gokberkgucin/MIT_Buck_Converter_Design_TAMAMLANDI/docs/assets/full-report/manifest.md

# Full Report Asset Manifest

Bu manifest, kaynak DOCX içindeki görselleri ve denklem görseli gibi teknik medya varlıklarını semantik dosya adlarıyla izler.

## Özet

- Kaynak DOCX: `Birinci_donem_Buck_Converter_Serbest_Projesi.docx`
- Asset kökü: `docs/assets/full-report`
- Toplam medya varlığı: 53
- Mevcut repo görselinden yeniden kullanılan: 53
- Denklem/ifade görseli olarak tutulan: 14
- Decorative/küçük nesne olarak işaretlenen: 5
- Kaynak Word native denklem nesnesi: 151
- Kaynak Word native denklem paragrafı: 65

Not: Native OMML denklem nesneleri bu asset çıkarıcısında tahminle kırpılmadı. DOCX içinde bitmap olarak bulunan denklem/ifade görselleri `media_type=equation-image` olarak kataloglandı.

## Asset Tablosu

| filename | source_location | probable_section | nearby_text_or_caption | media_type | reused_existing_asset |
| --- | --- | --- | --- | --- | --- |
| `docs/assets/full-report/power-stage/image01-type-3-compensator-frequency-relations.png` | word/media/image1.png; relationship=rId17; image_kind=drawingml; document_order=1; source_heading=Frekans Seçim Kuralları ve Hesaplamalar | Bölüm 2.1 | Type-3 compensator frekans ilişkileri | equation-image | true |
| `docs/assets/full-report/power-stage/image02-frequency-ordering.png` | word/media/image2.png; relationship=rId18; image_kind=drawingml; document_order=2; source_heading=Frekans Seçim Kuralları ve Hesaplamalar | Bölüm 2.1 | Frekans sıralaması | technical-figure | true |
| `docs/assets/full-report/power-stage/image03-updated-power-stage-calculation-flow.png` | word/media/image3.png; relationship=rId19; image_kind=drawingml; document_order=3; source_heading=Güç Katı Hesaplamaları: | Bölüm 3.2 | Güç katı hesap akışı/devre görseli | technical-figure | true |
| `docs/assets/full-report/power-stage/image04-duty-cycle-36v-ltspice-check.jpeg` | word/media/image4.jpeg; relationship=rId20; image_kind=drawingml; document_order=4; source_heading=Güç Katı Hesaplamaları: | Bölüm 3.3 | 36 V duty-cycle kontrolü | simulation-screenshot | true |
| `docs/assets/full-report/power-stage/image05-duty-cycle-24v-ltspice-check.png` | word/media/image5.png; relationship=rId21; image_kind=drawingml; document_order=5; source_heading=Güç Katı Hesaplamaları: | Bölüm 3.3 | 24 V duty-cycle kontrolü | simulation-screenshot | true |
| `docs/assets/full-report/state-equations/image06-buck-converter-state-equations.png` | word/media/image6.png; relationship=rId22; image_kind=drawingml; document_order=6; source_heading=Çevirici Durum Denklemleri | Bölüm 4 | Durum denklemleri | equation-image | true |
| `docs/assets/full-report/state-equations/image07-esr-effect-output-voltage.png` | word/media/image7.png; relationship=rId23; image_kind=drawingml; document_order=7; source_heading=ESR Etkisi | Bölüm 4.1 | ESR etkisi | technical-figure | true |
| `docs/assets/full-report/state-equations/image08-current-voltage-general-waveforms.png` | word/media/image8.png; relationship=rId24; image_kind=drawingml; document_order=8; source_heading=ESR Etkisi | Bölüm 4.1 | Genel akım/gerilim dalga biçimleri | waveform-diagram | true |
| `docs/assets/full-report/state-equations/image09-waveform-label-small-signal.png` | word/media/image9.png; relationship=rId25; image_kind=drawingml; document_order=9; source_heading=Genel Dalga-Biçimleri | Bölüm 4.2 | Dalga biçimi etiket görseli | equation-image | true |
| `docs/assets/full-report/state-equations/image10-waveform-equation-label.png` | word/media/image10.png; relationship=rId26; image_kind=drawingml; document_order=10; source_heading=Genel Dalga-Biçimleri | Bölüm 4.2 | Dalga biçimi denklem/etiket görseli | equation-image | true |
| `docs/assets/full-report/state-equations/image11-buck-converter-general-waveforms.png` | word/media/image11.png; relationship=rId27; image_kind=drawingml; document_order=11; source_heading=Genel Dalga-Biçimleri | Bölüm 4.2 | Buck converter genel dalga biçimleri | waveform-diagram | true |
| `docs/assets/full-report/state-equations/image12-decorative-small-media-12.png` | word/media/image12.png; relationship=rId29; image_kind=vml; document_order=14; source_heading=Genel Dalga-Biçimleri | Bölüm 4.2 | Kaynak DOCX küçük medya nesnesi; eksiksiz aktarım için ölçeklenerek bağlandı | decorative | true |
| `docs/assets/full-report/state-equations/image13-decorative-small-media-13.png` | word/media/image13.png; relationship=rId31; image_kind=vml; document_order=13; source_heading=Genel Dalga-Biçimleri | Bölüm 4.2 | Kaynak DOCX küçük medya nesnesi; eksiksiz aktarım için ölçeklenerek bağlandı | decorative | true |
| `docs/assets/full-report/controller/image14-controller-design-transition-diagram.png` | word/media/image14.png; relationship=rId33; image_kind=drawingml; document_order=15; source_heading=kontrolcu tasarımı | Bölüm 5 | Kontrolcü tasarımı giriş diyagramı | block-diagram | true |
| `docs/assets/full-report/controller/image15-system-block-diagram.png` | word/media/image15.png; relationship=rId34; image_kind=drawingml; document_order=16; source_heading=kontrolcu tasarımı | Bölüm 5.1 | Sistem block diagramı | block-diagram | true |
| `docs/assets/full-report/controller/image16-closed-loop-expression-1.png` | word/media/image16.png; relationship=rId35; image_kind=drawingml; document_order=17; source_heading=kontrolcu tasarımı | Bölüm 5.1 | Kapalı çevrim ifade ilişkisi | equation-image | true |
| `docs/assets/full-report/controller/image17-closed-loop-expression-2.png` | word/media/image17.png; relationship=rId36; image_kind=drawingml; document_order=18; source_heading=kontrolcu tasarımı | Bölüm 5.1 | Kapalı çevrim ifade ilişkisi | equation-image | true |
| `docs/assets/full-report/controller/image18-open-loop-transfer-function-block-expression.png` | word/media/image18.png; relationship=rId37; image_kind=drawingml; document_order=19; source_heading=Kontrolcu Hesabı | Bölüm 5.3 | Açık çevrim transfer fonksiyonu | equation-image | true |
| `docs/assets/full-report/controller/image19-uncompensated-loop-gain-expression.png` | word/media/image19.png; relationship=rId38; image_kind=drawingml; document_order=20; source_heading=Kontrolcu Hesabı | Bölüm 5.3 | Uncompensated loop gain ifadesi | equation-image | true |
| `docs/assets/full-report/controller/image20-uncompensated-loop-gain-bode.png` | word/media/image20.png; relationship=rId39; image_kind=drawingml; document_order=21; source_heading=Kontrolcu Hesabı | Bölüm 5.3 | Uncompensated Bode diyagramı | bode-plot | true |
| `docs/assets/full-report/controller/image21-lead-compensator-bode-shape.png` | word/media/image21.png; relationship=rId40; image_kind=drawingml; document_order=22; source_heading=Kontrolcu Hesabı | Bölüm 5.4 | Lead compensator Bode davranışı | bode-plot | true |
| `docs/assets/full-report/controller/image22-lead-compensator-frequency-response.png` | word/media/image22.png; relationship=rId41; image_kind=drawingml; document_order=23; source_heading=Kontrolcu Hesabı | Bölüm 5.4 | Lead compensator frekans cevabı | bode-plot | true |
| `docs/assets/full-report/controller/image23-lead-compensated-open-loop-bode.png` | word/media/image23.png; relationship=rId42; image_kind=drawingml; document_order=24; source_heading=Kontrolcu Hesabı | Bölüm 5.4 | Lead sonrası açık çevrim Bode | bode-plot | true |
| `docs/assets/full-report/controller/image24-lag-pi-compensator-bode-shape.png` | word/media/image24.png; relationship=rId43; image_kind=drawingml; document_order=25; source_heading=Kontrolcu Hesabı | Bölüm 5.5 | Lag/PI compensator Bode davranışı | bode-plot | true |
| `docs/assets/full-report/controller/image25-pid-compensator-bode-curve.png` | word/media/image25.png; relationship=rId44; image_kind=drawingml; document_order=26; source_heading=Kontrolcu Hesabı | Bölüm 5.6 | PID compensator Bode eğrisi | bode-plot | true |
| `docs/assets/full-report/controller/image26-lt1215-opamp-gain-frequency.png` | word/media/image26.png; relationship=rId45; image_kind=drawingml; document_order=27; source_heading=Kontrolcu Hesabı | Bölüm 5.7 | LT1215 op-amp gain/frequency grafiği | technical-figure | true |
| `docs/assets/full-report/controller/image27-final-open-loop-bode.png` | word/media/image27.png; relationship=rId46; image_kind=drawingml; document_order=28; source_heading=Kontrolcu Hesabı | Bölüm 5.8 | Nihai açık çevrim Bode | bode-plot | true |
| `docs/assets/full-report/controller/image28-calculated-open-loop-transfer-function.png` | word/media/image28.png; relationship=rId47; image_kind=drawingml; document_order=29; source_heading=Kontrolcu Hesabı | Bölüm 5.8 | Hesaplanan $T(s)$ | equation-image | true |
| `docs/assets/full-report/controller/image29-t-of-s-closed-loop-expressions.png` | word/media/image29.png; relationship=rId48; image_kind=drawingml; document_order=30; source_heading=Kontrolcu Hesabı | Bölüm 5.8 | $T(s)$ kapalı çevrim ifadeleri | equation-image | true |
| `docs/assets/full-report/controller/image30-decorative-small-media-30.png` | word/media/image30.png; relationship=rId50; image_kind=vml; document_order=32; source_heading=Kontrolcu Hesabı | Bölüm 5.8 | Kaynak DOCX küçük medya nesnesi; eksiksiz aktarım için ölçeklenerek bağlandı | decorative | true |
| `docs/assets/full-report/controller/image31-closed-loop-reference-to-output-response.png` | word/media/image31.png; relationship=rId51; image_kind=drawingml; document_order=31; source_heading=Kontrolcu Hesabı | Bölüm 5.8 | Reference-to-output cevabı | bode-plot | true |
| `docs/assets/full-report/opamp/image32-decorative-small-media-32.png` | word/media/image32.png; relationship=rId53; image_kind=vml; document_order=33; source_heading=Op-amp devresi -gerçeklemesi | Bölüm 6 | Kaynak DOCX küçük medya nesnesi; eksiksiz aktarım için ölçeklenerek bağlandı | decorative | true |
| `docs/assets/full-report/opamp/image33-decorative-small-media-33.png` | word/media/image33.png; relationship=rId55; image_kind=vml; document_order=34; source_heading=Op-amp devresi -gerçeklemesi | Bölüm 6 | Kaynak DOCX küçük medya nesnesi; eksiksiz aktarım için ölçeklenerek bağlandı | decorative | true |
| `docs/assets/full-report/opamp/image34-opamp-implementation-circuit.png` | word/media/image34.png; relationship=rId56; image_kind=drawingml; document_order=35; source_heading=Op-amp devresi -gerçeklemesi | Bölüm 6 | Op-amp gerçekleştirme devresi | circuit-diagram | true |
| `docs/assets/full-report/opamp/image35-sensor-gain-voltage-divider.png` | word/media/image35.png; relationship=rId57; image_kind=drawingml; document_order=36; source_heading=Sensor Gain (H(s)) | Bölüm 6.1 | Sensor gain gerilim bölücü | circuit-diagram | true |
| `docs/assets/full-report/opamp/image36-compensator-target-frequency-gain.png` | word/media/image36.png; relationship=rId58; image_kind=drawingml; document_order=37; source_heading=Compensator Devresi | Bölüm 6.2 | Compensator hedef frekans/kazanç davranışı | technical-figure | true |
| `docs/assets/full-report/opamp/image37-simplified-compensator-circuit.png` | word/media/image37.png; relationship=rId59; image_kind=drawingml; document_order=38; source_heading=Compensator Devresi | Bölüm 6.2 | Sadeleştirilmiş compensator devresi | circuit-diagram | true |
| `docs/assets/full-report/opamp/image38-r2-c2-impedance-comparison.png` | word/media/image38.png; relationship=rId60; image_kind=drawingml; document_order=42; source_heading=Compensator Devresi | Bölüm 6.2 | $R_2$ ve $C_2$ empedans davranışı | equation-image | true |
| `docs/assets/full-report/opamp/image39-capacitor-impedance-plus-20db-dec.png` | word/media/image39.png; relationship=rId61; image_kind=drawingml; document_order=40; source_heading=Compensator Devresi | Bölüm 6.2 | $+20\,\text{dB/dec}$ eğim | equation-image | true |
| `docs/assets/full-report/opamp/image40-z1-z2-impedance-network-1.png` | word/media/image40.png; relationship=rId62; image_kind=drawingml; document_order=41; source_heading=Compensator Devresi | Bölüm 6.2 | $Z_1/Z_2$ empedans ağı | equation-image | true |
| `docs/assets/full-report/opamp/image41-z1-z2-impedance-network-2.png` | word/media/image41.png; relationship=rId63; image_kind=drawingml; document_order=43; source_heading=Compensator Devresi | Bölüm 6.2 | $Z_1/Z_2$ empedans ağı | equation-image | true |
| `docs/assets/full-report/simulation/image42-output-power-50w-operating-point.png` | word/media/image42.png; relationship=rId64; image_kind=drawingml; document_order=44; source_heading=Çıkış Gücü | Bölüm 7.3 | Yaklaşık 49.6 W çıkış gücü | simulation-screenshot | true |
| `docs/assets/full-report/simulation/image43-output-power-125w-operating-point.png` | word/media/image43.png; relationship=rId65; image_kind=drawingml; document_order=45; source_heading=Çıkış Gücü | Bölüm 7.3 | Yaklaşık 124.2 W çıkış gücü | simulation-screenshot | true |
| `docs/assets/full-report/simulation/image44-static-output-voltage-measurement.png` | word/media/image44.png; relationship=rId66; image_kind=drawingml; document_order=46; source_heading=Output Voltage (static requirement): | Bölüm 7.4 | Statik çıkış gerilimi | simulation-screenshot | true |
| `docs/assets/full-report/simulation/image45-transient-output-voltage-load-current.png` | word/media/image45.png; relationship=rId67; image_kind=drawingml; document_order=47; source_heading=Output Voltage (transient limits): | Bölüm 7.5 | Transient çıkış gerilimi | simulation-screenshot | true |
| `docs/assets/full-report/simulation/image46-output-ripple-measurement.png` | word/media/image46.png; relationship=rId68; image_kind=drawingml; document_order=48; source_heading=Output Voltage (transient limits): | Bölüm 7.6 | Output ripple | simulation-screenshot | true |
| `docs/assets/full-report/simulation/image47-input-power-36v-measurement.png` | word/media/image47.png; relationship=rId69; image_kind=drawingml; document_order=49; source_heading=Allowed output voltage ripple (p-p, any R load) | Bölüm 7.7 | 36 V girişte giriş gücü | simulation-screenshot | true |
| `docs/assets/full-report/simulation/image48-output-power-36v-measurement.png` | word/media/image48.png; relationship=rId70; image_kind=drawingml; document_order=50; source_heading=Allowed output voltage ripple (p-p, any R load) | Bölüm 7.7 | 36 V girişte çıkış gücü | simulation-screenshot | true |
| `docs/assets/full-report/simulation/image49-output-power-24v-measurement.png` | word/media/image49.png; relationship=rId71; image_kind=drawingml; document_order=51; source_heading=Allowed output voltage ripple (p-p, any R load) | Bölüm 7.7 | 24 V girişte çıkış gücü | simulation-screenshot | true |
| `docs/assets/full-report/simulation/image50-input-power-24v-measurement.png` | word/media/image50.png; relationship=rId72; image_kind=drawingml; document_order=52; source_heading=Allowed output voltage ripple (p-p, any R load) | Bölüm 7.7 | 24 V girişte giriş gücü | simulation-screenshot | true |
| `docs/assets/full-report/future-work/image51-lm5146-typical-application.png` | word/media/image51.png; relationship=rId73; image_kind=drawingml; document_order=53; source_heading=PROJENIN GELECEĞİ | Bölüm 8 | LM5146 tipik uygulama | circuit-diagram | true |
| `docs/assets/full-report/appendices/image52-output-capacitor-datasheet-excerpt.png` | word/media/image52.png; relationship=rId74; image_kind=drawingml; document_order=54; source_heading=EK-2. Genel görünüm | Ek-1 | Sığaç veri sayfası | datasheet-excerpt | true |
| `docs/assets/full-report/appendices/image53-ltspice-circuit-overview.png` | word/media/image53.png; relationship=rId75; image_kind=drawingml; document_order=55; source_heading=EK-2. Genel görünüm | Ek-2 | LTspice devre genel görünümü | circuit-diagram | true |

## Yeniden Kullanılan Mevcut Görseller

| semantic_filename | source_asset | link_method | matching_existing_assets |
| --- | --- | --- | --- |
| `docs/assets/full-report/power-stage/image01-type-3-compensator-frequency-relations.png` | `docs/assets/docx-media/media/image1.png` | hardlink-existing | `docs/assets/docx-media/media/image1.png`, `docs/assets/docx-media/raw/image1.png`, `images/readme/type3_frequency_relations.png`, `images/docx_extracted/image1.png` |
| `docs/assets/full-report/power-stage/image02-frequency-ordering.png` | `docs/assets/docx-media/media/image2.png` | hardlink-existing | `docs/assets/docx-media/media/image2.png`, `docs/assets/docx-media/raw/image2.png`, `images/readme/frequency_ordering.png`, `images/docx_extracted/image2.png` |
| `docs/assets/full-report/power-stage/image03-updated-power-stage-calculation-flow.png` | `docs/assets/docx-media/media/image3.png` | hardlink-existing | `docs/assets/docx-media/media/image3.png`, `docs/assets/docx-media/raw/image3.png` |
| `docs/assets/full-report/power-stage/image04-duty-cycle-36v-ltspice-check.jpeg` | `docs/assets/docx-media/media/image4.jpeg` | hardlink-existing | `docs/assets/docx-media/media/image4.jpeg`, `docs/assets/docx-media/raw/image4.jpeg` |
| `docs/assets/full-report/power-stage/image05-duty-cycle-24v-ltspice-check.png` | `docs/assets/docx-media/media/image5.png` | hardlink-existing | `docs/assets/docx-media/media/image5.png`, `docs/assets/docx-media/raw/image5.png` |
| `docs/assets/full-report/state-equations/image06-buck-converter-state-equations.png` | `docs/assets/docx-media/media/image6.png` | hardlink-existing | `docs/assets/docx-media/media/image6.png`, `docs/assets/docx-media/raw/image6.png`, `images/readme/converter_state_equations.png`, `images/docx_extracted/image6.png` |
| `docs/assets/full-report/state-equations/image07-esr-effect-output-voltage.png` | `docs/assets/docx-media/media/image7.png` | hardlink-existing | `docs/assets/docx-media/media/image7.png`, `docs/assets/docx-media/raw/image7.png` |
| `docs/assets/full-report/state-equations/image08-current-voltage-general-waveforms.png` | `docs/assets/docx-media/media/image8.png` | hardlink-existing | `docs/assets/docx-media/media/image8.png`, `docs/assets/docx-media/raw/image8.png` |
| `docs/assets/full-report/state-equations/image09-waveform-label-small-signal.png` | `docs/assets/docx-media/media/image9.png` | hardlink-existing | `docs/assets/docx-media/media/image9.png`, `docs/assets/docx-media/raw/image9.png` |
| `docs/assets/full-report/state-equations/image10-waveform-equation-label.png` | `docs/assets/docx-media/media/image10.png` | hardlink-existing | `docs/assets/docx-media/media/image10.png`, `docs/assets/docx-media/raw/image10.png` |
| `docs/assets/full-report/state-equations/image11-buck-converter-general-waveforms.png` | `docs/assets/docx-media/media/image11.png` | hardlink-existing | `docs/assets/docx-media/media/image11.png`, `docs/assets/docx-media/raw/image11.png` |
| `docs/assets/full-report/state-equations/image12-decorative-small-media-12.png` | `docs/assets/docx-media/media/image12.png` | hardlink-existing | `docs/assets/docx-media/media/image12.png`, `docs/assets/docx-media/raw/image12.png` |
| `docs/assets/full-report/state-equations/image13-decorative-small-media-13.png` | `docs/assets/docx-media/media/image13.png` | hardlink-existing | `docs/assets/docx-media/media/image13.png`, `docs/assets/docx-media/raw/image13.png` |
| `docs/assets/full-report/controller/image14-controller-design-transition-diagram.png` | `docs/assets/docx-media/media/image14.png` | hardlink-existing | `docs/assets/docx-media/media/image14.png`, `docs/assets/docx-media/raw/image14.png`, `images/readme/control_system_block.png`, `images/docx_extracted/image14.png` |
| `docs/assets/full-report/controller/image15-system-block-diagram.png` | `docs/assets/docx-media/media/image15.png` | hardlink-existing | `docs/assets/docx-media/media/image15.png`, `docs/assets/docx-media/raw/image15.png` |
| `docs/assets/full-report/controller/image16-closed-loop-expression-1.png` | `docs/assets/docx-media/media/image16.png` | hardlink-existing | `docs/assets/docx-media/media/image16.png`, `docs/assets/docx-media/raw/image16.png`, `images/readme/closed_loop_expression_1.png`, `images/docx_extracted/image16.png` |
| `docs/assets/full-report/controller/image17-closed-loop-expression-2.png` | `docs/assets/docx-media/media/image17.png` | hardlink-existing | `docs/assets/docx-media/media/image17.png`, `docs/assets/docx-media/raw/image17.png`, `images/readme/closed_loop_expression_2.png`, `images/docx_extracted/image17.png` |
| `docs/assets/full-report/controller/image18-open-loop-transfer-function-block-expression.png` | `docs/assets/docx-media/media/image18.png` | hardlink-existing | `docs/assets/docx-media/media/image18.png`, `docs/assets/docx-media/raw/image18.png`, `images/readme/open_loop_expression.png`, `images/docx_extracted/image18.png` |
| `docs/assets/full-report/controller/image19-uncompensated-loop-gain-expression.png` | `docs/assets/docx-media/media/image19.png` | hardlink-existing | `docs/assets/docx-media/media/image19.png`, `docs/assets/docx-media/raw/image19.png`, `images/readme/uncompensated_loop_expression.png`, `images/docx_extracted/image19.png` |
| `docs/assets/full-report/controller/image20-uncompensated-loop-gain-bode.png` | `docs/assets/docx-media/media/image20.png` | hardlink-existing | `docs/assets/docx-media/media/image20.png`, `docs/assets/docx-media/raw/image20.png`, `images/readme/uncompensated_loop_bode.png`, `images/docx_extracted/image20.png` |
| `docs/assets/full-report/controller/image21-lead-compensator-bode-shape.png` | `docs/assets/docx-media/media/image21.png` | hardlink-existing | `docs/assets/docx-media/media/image21.png`, `docs/assets/docx-media/raw/image21.png`, `images/readme/lead_compensator_shape.png`, `images/docx_extracted/image21.png` |
| `docs/assets/full-report/controller/image22-lead-compensator-frequency-response.png` | `docs/assets/docx-media/media/image22.png` | hardlink-existing | `docs/assets/docx-media/media/image22.png`, `docs/assets/docx-media/raw/image22.png` |
| `docs/assets/full-report/controller/image23-lead-compensated-open-loop-bode.png` | `docs/assets/docx-media/media/image23.png` | hardlink-existing | `docs/assets/docx-media/media/image23.png`, `docs/assets/docx-media/raw/image23.png` |
| `docs/assets/full-report/controller/image24-lag-pi-compensator-bode-shape.png` | `docs/assets/docx-media/media/image24.png` | hardlink-existing | `docs/assets/docx-media/media/image24.png`, `docs/assets/docx-media/raw/image24.png`, `images/readme/lag_compensator_shape.png`, `images/docx_extracted/image24.png` |
| `docs/assets/full-report/controller/image25-pid-compensator-bode-curve.png` | `docs/assets/docx-media/media/image25.png` | hardlink-existing | `docs/assets/docx-media/media/image25.png`, `docs/assets/docx-media/raw/image25.png` |
| `docs/assets/full-report/controller/image26-lt1215-opamp-gain-frequency.png` | `docs/assets/docx-media/media/image26.png` | hardlink-existing | `docs/assets/docx-media/media/image26.png`, `docs/assets/docx-media/raw/image26.png`, `images/readme/opamp_gain_frequency_docx.png`, `images/docx_extracted/image26.png` |
| `docs/assets/full-report/controller/image27-final-open-loop-bode.png` | `docs/assets/docx-media/media/image27.png` | hardlink-existing | `docs/assets/docx-media/media/image27.png`, `docs/assets/docx-media/raw/image27.png`, `images/readme/final_loop_gain.png`, `images/docx_extracted/image27.png` |
| `docs/assets/full-report/controller/image28-calculated-open-loop-transfer-function.png` | `docs/assets/docx-media/media/image28.png` | hardlink-existing | `docs/assets/docx-media/media/image28.png`, `docs/assets/docx-media/raw/image28.png`, `images/readme/t_of_s_block_diagram.png`, `images/docx_extracted/image28.png` |
| `docs/assets/full-report/controller/image29-t-of-s-closed-loop-expressions.png` | `docs/assets/docx-media/media/image29.png` | hardlink-existing | `docs/assets/docx-media/media/image29.png`, `docs/assets/docx-media/raw/image29.png`, `images/readme/vhat_expression.png`, `images/docx_extracted/image29.png` |
| `docs/assets/full-report/controller/image30-decorative-small-media-30.png` | `docs/assets/docx-media/media/image30.png` | hardlink-existing | `docs/assets/docx-media/media/image30.png`, `docs/assets/docx-media/raw/image30.png` |
| `docs/assets/full-report/controller/image31-closed-loop-reference-to-output-response.png` | `docs/assets/docx-media/media/image31.png` | hardlink-existing | `docs/assets/docx-media/media/image31.png`, `docs/assets/docx-media/raw/image31.png` |
| `docs/assets/full-report/opamp/image32-decorative-small-media-32.png` | `docs/assets/docx-media/media/image32.png` | hardlink-existing | `docs/assets/docx-media/media/image32.png`, `docs/assets/docx-media/raw/image32.png` |
| `docs/assets/full-report/opamp/image33-decorative-small-media-33.png` | `docs/assets/docx-media/media/image33.png` | hardlink-existing | `docs/assets/docx-media/media/image33.png`, `docs/assets/docx-media/raw/image33.png` |
| `docs/assets/full-report/opamp/image34-opamp-implementation-circuit.png` | `docs/assets/docx-media/media/image34.png` | hardlink-existing | `docs/assets/docx-media/media/image34.png`, `docs/assets/docx-media/raw/image34.png` |
| `docs/assets/full-report/opamp/image35-sensor-gain-voltage-divider.png` | `docs/assets/docx-media/media/image35.png` | hardlink-existing | `docs/assets/docx-media/media/image35.png`, `docs/assets/docx-media/raw/image35.png` |
| `docs/assets/full-report/opamp/image36-compensator-target-frequency-gain.png` | `docs/assets/docx-media/media/image36.png` | hardlink-existing | `docs/assets/docx-media/media/image36.png`, `docs/assets/docx-media/raw/image36.png` |
| `docs/assets/full-report/opamp/image37-simplified-compensator-circuit.png` | `docs/assets/docx-media/media/image37.png` | hardlink-existing | `docs/assets/docx-media/media/image37.png`, `docs/assets/docx-media/raw/image37.png` |
| `docs/assets/full-report/opamp/image38-r2-c2-impedance-comparison.png` | `docs/assets/docx-media/media/image38.png` | hardlink-existing | `docs/assets/docx-media/media/image38.png`, `docs/assets/docx-media/raw/image38.png` |
| `docs/assets/full-report/opamp/image39-capacitor-impedance-plus-20db-dec.png` | `docs/assets/docx-media/media/image39.png` | hardlink-existing | `docs/assets/docx-media/media/image39.png`, `docs/assets/docx-media/raw/image39.png` |
| `docs/assets/full-report/opamp/image40-z1-z2-impedance-network-1.png` | `docs/assets/docx-media/media/image40.png` | hardlink-existing | `docs/assets/docx-media/media/image40.png`, `docs/assets/docx-media/raw/image40.png` |
| `docs/assets/full-report/opamp/image41-z1-z2-impedance-network-2.png` | `docs/assets/docx-media/media/image41.png` | hardlink-existing | `docs/assets/docx-media/media/image41.png`, `docs/assets/docx-media/raw/image41.png` |
| `docs/assets/full-report/simulation/image42-output-power-50w-operating-point.png` | `docs/assets/docx-media/media/image42.png` | hardlink-existing | `docs/assets/docx-media/media/image42.png`, `docs/assets/docx-media/raw/image42.png` |
| `docs/assets/full-report/simulation/image43-output-power-125w-operating-point.png` | `docs/assets/docx-media/media/image43.png` | hardlink-existing | `docs/assets/docx-media/media/image43.png`, `docs/assets/docx-media/raw/image43.png` |
| `docs/assets/full-report/simulation/image44-static-output-voltage-measurement.png` | `docs/assets/docx-media/media/image44.png` | hardlink-existing | `docs/assets/docx-media/media/image44.png`, `docs/assets/docx-media/raw/image44.png` |
| `docs/assets/full-report/simulation/image45-transient-output-voltage-load-current.png` | `docs/assets/docx-media/media/image45.png` | hardlink-existing | `docs/assets/docx-media/media/image45.png`, `docs/assets/docx-media/raw/image45.png` |
| `docs/assets/full-report/simulation/image46-output-ripple-measurement.png` | `docs/assets/docx-media/media/image46.png` | hardlink-existing | `docs/assets/docx-media/media/image46.png`, `docs/assets/docx-media/raw/image46.png` |
| `docs/assets/full-report/simulation/image47-input-power-36v-measurement.png` | `docs/assets/docx-media/media/image47.png` | hardlink-existing | `docs/assets/docx-media/media/image47.png`, `docs/assets/docx-media/raw/image47.png` |
| `docs/assets/full-report/simulation/image48-output-power-36v-measurement.png` | `docs/assets/docx-media/media/image48.png` | hardlink-existing | `docs/assets/docx-media/media/image48.png`, `docs/assets/docx-media/raw/image48.png` |
| `docs/assets/full-report/simulation/image49-output-power-24v-measurement.png` | `docs/assets/docx-media/media/image49.png` | hardlink-existing | `docs/assets/docx-media/media/image49.png`, `docs/assets/docx-media/raw/image49.png` |
| `docs/assets/full-report/simulation/image50-input-power-24v-measurement.png` | `docs/assets/docx-media/media/image50.png` | hardlink-existing | `docs/assets/docx-media/media/image50.png`, `docs/assets/docx-media/raw/image50.png` |
| `docs/assets/full-report/future-work/image51-lm5146-typical-application.png` | `docs/assets/docx-media/media/image51.png` | hardlink-existing | `docs/assets/docx-media/media/image51.png`, `docs/assets/docx-media/raw/image51.png` |
| `docs/assets/full-report/appendices/image52-output-capacitor-datasheet-excerpt.png` | `docs/assets/docx-media/media/image52.png` | hardlink-existing | `docs/assets/docx-media/media/image52.png`, `docs/assets/docx-media/raw/image52.png` |
| `docs/assets/full-report/appendices/image53-ltspice-circuit-overview.png` | `docs/assets/docx-media/media/image53.png` | hardlink-existing | `docs/assets/docx-media/media/image53.png`, `docs/assets/docx-media/raw/image53.png` |

## LaTeX Yerine Görsel Tutulan Denklem/İfade Varlıkları

| filename | original_media | probable_section | nearby_text_or_caption |
| --- | --- | --- | --- |
| `docs/assets/full-report/power-stage/image01-type-3-compensator-frequency-relations.png` | word/media/image1.png | Bölüm 2.1 | Type-3 compensator frekans ilişkileri |
| `docs/assets/full-report/state-equations/image06-buck-converter-state-equations.png` | word/media/image6.png | Bölüm 4 | Durum denklemleri |
| `docs/assets/full-report/state-equations/image09-waveform-label-small-signal.png` | word/media/image9.png | Bölüm 4.2 | Dalga biçimi etiket görseli |
| `docs/assets/full-report/state-equations/image10-waveform-equation-label.png` | word/media/image10.png | Bölüm 4.2 | Dalga biçimi denklem/etiket görseli |
| `docs/assets/full-report/controller/image16-closed-loop-expression-1.png` | word/media/image16.png | Bölüm 5.1 | Kapalı çevrim ifade ilişkisi |
| `docs/assets/full-report/controller/image17-closed-loop-expression-2.png` | word/media/image17.png | Bölüm 5.1 | Kapalı çevrim ifade ilişkisi |
| `docs/assets/full-report/controller/image18-open-loop-transfer-function-block-expression.png` | word/media/image18.png | Bölüm 5.3 | Açık çevrim transfer fonksiyonu |
| `docs/assets/full-report/controller/image19-uncompensated-loop-gain-expression.png` | word/media/image19.png | Bölüm 5.3 | Uncompensated loop gain ifadesi |
| `docs/assets/full-report/controller/image28-calculated-open-loop-transfer-function.png` | word/media/image28.png | Bölüm 5.8 | Hesaplanan $T(s)$ |
| `docs/assets/full-report/controller/image29-t-of-s-closed-loop-expressions.png` | word/media/image29.png | Bölüm 5.8 | $T(s)$ kapalı çevrim ifadeleri |
| `docs/assets/full-report/opamp/image38-r2-c2-impedance-comparison.png` | word/media/image38.png | Bölüm 6.2 | $R_2$ ve $C_2$ empedans davranışı |
| `docs/assets/full-report/opamp/image39-capacitor-impedance-plus-20db-dec.png` | word/media/image39.png | Bölüm 6.2 | $+20\,\text{dB/dec}$ eğim |
| `docs/assets/full-report/opamp/image40-z1-z2-impedance-network-1.png` | word/media/image40.png | Bölüm 6.2 | $Z_1/Z_2$ empedans ağı |
| `docs/assets/full-report/opamp/image41-z1-z2-impedance-network-2.png` | word/media/image41.png | Bölüm 6.2 | $Z_1/Z_2$ empedans ağı |

## Decorative / Minik Nesneler

| filename | original_media | bytes | dimensions | note |
| --- | --- | --- | --- | --- |
| `docs/assets/full-report/state-equations/image12-decorative-small-media-12.png` | word/media/image12.png | 150 | 2x2 | Kaynak DOCX küçük medya nesnesi; eksiksiz aktarım için ölçeklenerek bağlandı |
| `docs/assets/full-report/state-equations/image13-decorative-small-media-13.png` | word/media/image13.png | 157 | 2x2 | Kaynak DOCX küçük medya nesnesi; eksiksiz aktarım için ölçeklenerek bağlandı |
| `docs/assets/full-report/controller/image30-decorative-small-media-30.png` | word/media/image30.png | 150 | 2x2 | Kaynak DOCX küçük medya nesnesi; eksiksiz aktarım için ölçeklenerek bağlandı |
| `docs/assets/full-report/opamp/image32-decorative-small-media-32.png` | word/media/image32.png | 165 | 3x3 | Kaynak DOCX küçük medya nesnesi; eksiksiz aktarım için ölçeklenerek bağlandı |
| `docs/assets/full-report/opamp/image33-decorative-small-media-33.png` | word/media/image33.png | 165 | 3x3 | Kaynak DOCX küçük medya nesnesi; eksiksiz aktarım için ölçeklenerek bağlandı |
