gokberkgucin/MIT_Buck_Converter_Design_TAMAMLANDI/docs/migration-gap-report.md

# Migration Gap Report

Bu audit, kaynak DOCX belgesi ile mevcut GitHub dokümantasyonunu karşılaştırır. Bu adımda ana içerik dosyaları yeniden yazılmadı; yalnızca gap raporu ve coverage CSV üretildi.

## Kapsam

İncelenen ana dosyalar:

- `Birinci_donem_Buck_Converter_Serbest_Projesi.docx`
- `README.md`
- `docs/full-report.md`
- `docs/index.md`
- `docs/source-map.md`
- `docs/TRANSFER_AUDIT.md`
- `docs/verification-summary.md`
- `FINAL_QA.md`
- `images/`
- `docs/assets/docx-media/`
- `LTspice_AveragedSwitchModelingSimulation/`

Source of truth sırası:

1. `Birinci_donem_Buck_Converter_Serbest_Projesi.docx`
2. Yereldeki görseller, simülasyon ekran görüntüleri ve LTspice dosyaları
3. Mevcut Markdown dokümantasyonu

## Kısa Sonuç

Repo artık güçlü bir teknik dokümantasyon yapısına sahip. `docs/full-report.md` kaynak tezin ana omurgasını büyük ölçüde taşıyor; 53 DOCX medya dosyasının tamamı rapora bağlı, kırık görsel ve kırık repo içi link saptanmadı.

Buna rağmen bu audit birkaç önemli gap buldu:

- Kaynak DOCX içinde gerçek bir Word bookmark alan hatası var; hedef Markdown TOC içine taşınmadı.
- Kapak/onay bölümünde doldurulmamış şablon alanları var; hedef yayın sürümünde bu yer tutucular taşınmadı.
- Denklem aktarımı teknik olarak güçlü ama birebir OOXML denklem nesnesi karşılığı değil; kaynakta 151 `oMath` ve 65 `oMathPara` nesnesi var.
- Kaynakta 28 Word tablo var; hedefte tablolar Markdown'a yeniden kurulmuş, birebir tablo sayısı korunmamış.
- Bazı simülasyon/ek görselleri hedefte semantik olarak daha doğru yerlere taşınmış görünüyor; ancak ham DOCX section attribution ile tam aynı değil.
- `docs/index.md` içinde küçük medya nesneleri için eski bir not kalmış: artık full-report içinde bağlı oldukları halde "ana akışa gömülmemiştir" deniyor.
- `docs/TRANSFER_AUDIT.md` ilk dönüşümden kalan bazı metrikleri taşıyor; güncel manuel düzeltmelerden sonra tarihsel audit olarak değerlendirilmeli.

## Kaynak DOCX Metrikleri

OOXML üzerinden çıkarılan kaynak metrikleri:

| Metrik | Değer |
|---|---:|
| Başlık sayısı | 32 |
| Boş olmayan paragraf bloğu | 240 |
| Word tablo sayısı | 28 |
| `oMath` denklem nesnesi | 151 |
| `oMathPara` denklem paragrafı | 65 |
| Drawing nesnesi | 55 |
| İlişkili medya dosyası | 53 |
| Word bookmark start | 116 |

Önemli kaynak artefaktları:

- Kaynak DOCX metninde bozuk TEŞEKKÜR bookmark alanı var.
- Kapak/onay sayfasında doldurulmamış şablon metinleri var.
- Bazı görseller ham OOXML bölüm sınırlarında semantik başlığından farklı section altında sayılıyor. Özellikle ripple/verimlilik ve ek görsellerinde PDF render sırası ile son kontrol önerilir.

## Hedef Repo Metrikleri

Mevcut hedef durum:

| Metrik | Değer |
|---|---:|
| `docs/full-report.md` başlık sayısı | 51 |
| Full report görsel referansı | 54 |
| Benzersiz bağlı DOCX medya hedefi | 53 / 53 |
| Markdown table block sayısı | 10 |
| Markdown table row sayısı | 100 |
| Display math block sayısı | 118 |
| Inline math kaba sayımı | 309 |
| QA kırık link | 0 |
| QA eksik görsel | 0 |
| QA kullanılmayan DOCX medya | 0 |
| QA mojibake dosyası | 0 |
| QA açık yapılacak-notu | 0 |

Not: Markdown tablo ve denklem sayıları Word tablo/denklem sayılarıyla birebir aynı anlama gelmez. Kaynak Word dosyasında birçok tablo denklem veya layout taşıyıcısı olarak kullanılmıştır.

## Başlık Omurgası Denetimi

Detaylı satırlar `docs/migration-coverage.csv` içinde verildi. Özet tablo:

| Kaynak başlık / alan | Durum | Ana bulgu |
|---|---|---|
| ABSTRACT | TAM | Abstract ve key words aktarılmış. |
| GİRİŞ | TAM | Başlık omurgası korunmuş. |
| Çalışmanın Amacı ve Kapsamı | TAM | Paragraf bloğu aktarılmış. |
| Buck Converter Nedir? | TAM | Tanım aktarılmış. |
| Güç ve Kontrol Tasarımında İzlenen Yöntem | TAM | Ana teknik anlatım korunmuş. |
| Frekans Seçim Kuralları ve Hesaplamalar | TAM | Kritik frekans ilişkileri ve görseller korunmuş. |
| Hesaplamalarda Kullanılacak Parametreler | KISMİ | Hedefte yararlı tablo var; kaynak section sınırıyla birebir değil. |
| Güç Katı Hesaplamaları | KISMİ | Teknik akış korunmuş, denklemler birebir OOXML eşleşmesi değil. |
| Çevirici Durum Denklemleri | KISMİ | Denklem görseli korunmuş; tam LaTeX çözüm yok. |
| ESR Etkisi | TAM | Metin ve görseller korunmuş. |
| Genel Dalga-Biçimleri | TAM | Tüm medya, küçük nesneler dahil, bağlı. |
| Kontrolcü Tasarımı | TAM | Block diagram ve kontrol akışı korunmuş. |
| Kontrolcü Hesabı | KISMİ | Kritik denklemler ve Bode görselleri var; equation-object birebirliği yok. |
| Op-amp devresi -gerçeklemesi | TAM | Küçük medya ve op-amp devresi bağlı. |
| Sensor Gain (H(s)) | TAM | R3/R5 ve H değeri aktarılmış. |
| Compensator Devresi | KISMİ | Mantık ve eleman değerleri aktarılmış; denklem/table birebirliği yok. |
| Benzetim sonuçları | TAM | Doğrulama akışı korunmuş. |
| Tasarım Gereksinimleri | TAM | Gereksinimler tabloya dönüştürülmüş. |
| Benzetimde kullanılan elemanlar ve parametreler | TAM | Parametreler güçlü tablo halinde. |
| Çıkış Gücü | TAM | 49.5957 W ve 124.1839 W kanıtları var. |
| Output Voltage static requirement | TAM | Yaklaşık %1.30 ve image44 var. |
| Output Voltage transient limits | KISMİ | image46 hedefte ripple'a taşınmış; semantik doğru, PDF sırası ile doğrulanmalı. |
| Allowed output voltage ripple | KISMİ | image47-image50 hedefte verimlilik altında; semantik doğru, PDF sırası ile doğrulanmalı. |
| Verimlilik | KISMİ | Kaynak section sınırı boş görünüyor; hedefte verim hesabı ve görseller doğru yerde toplanmış. |
| Hesaplamaların Doğrulanması | TAM | Maddeler ve sonuç özeti aktarılmış. |
| PROJENIN GELECEĞİ | TAM | Sonraki çalışma maddeleri aktarılmış. |
| KAYNAKLAR | TAM | Referanslar temizlenmiş. |
| EKLER | TAM | Omurga korunmuş. |
| EK-1. Sığaç Verisayfası | KISMİ | image52 semantik olarak doğru yerde; ham OOXML section attribution EK-2'ye bağlı görünüyor. |
| EK-2. Genel görünüm | TAM | image53 bağlı. |

## Bulgu Türleri

### TAM

Bu etiket, kaynak başlık/alanın hedefte okunabilir ve teknik olarak yeterli biçimde temsil edildiği yerler için kullanıldı. Örnekler:

- Abstract
- Giriş alt bölümleri
- Frekans seçim mantığı
- ESR etkisi
- Sensor gain
- Çıkış gücü ve statik çıkış doğrulaması

### KISMİ

Bu etiket, teknik içeriğin hedefte bulunduğu fakat kaynak formatıyla birebir aynı olmadığı yerler için kullanıldı. En yaygın nedenler:

- Word denklemlerinin Markdown/LaTeX'e yeniden yazılması
- Word tablolarının Markdown tablolarına yeniden kurgulanması
- Ham DOCX section attribution ile semantik hedef yerleşimin ayrışması

Önemli kısmi alanlar:

- Güç katı hesaplamaları
- Kontrolcü hesabı
- Compensator devresi
- Denklem rendering genel
- Tablo aktarımı genel

### EKSİK

Bu audit kapsamında kaynak DOCX’in ana başlık omurgasında doğrudan tamamen eksik bir ana bölüm saptanmadı. Ancak repo dışı/yardımcı artefakt düzeyinde takip gerekenler var:

- `LTspice_AveragedSwitchModelingSimulation/SyncBuck_switching_CL.raw` yerelde var ama yaklaşık 523 MB olduğu için GitHub commit dışında bırakılmış.
- Input voltage transient, input current ripple ve sıcaklık sweep için kaynak rapor hedefleri listeliyor ama ayrı simülasyon dalga şekli/kanıtı sunmuyor. Bu bir migration hatası değil, kaynak kapsam boşluğu.

### YANLIŞ

Net yanlış bilgi saptanan yer:

- `docs/index.md` içinde küçük medya nesneleri için "ana akışa gömülmemiştir" deniyor. Son durumda `image12.png`, `image13.png`, `image30.png`, `image32.png`, `image33.png` full report içinde bağlı ve ölçeklenmiş durumda.

### KARAKTER_SORUNU

Gerçek UTF-8 dosya içeriğinde yaygın mojibake veya replacement-character saptanmadı. PowerShell çıktılarında görülen sahte Türkçe karakter bozulmaları terminal kod sayfası kaynaklı görünüyor; Python UTF-8 okuması temiz.

### YANLIŞ_KONUMLANDIRMA

Ham DOCX section attribution ile hedefin semantik yerleşimi arasında bazı farklar var:

- `image46.png` ham metriklerde transient section altında görünüyor; hedefte ripple altında.
- `image47.png`-`image50.png` ham metriklerde ripple section altında görünüyor; hedefte verimlilik altında.
- `image52.png` ham metriklerde EK-2 altında sayılıyor; hedefte EK-1 sığaç verisayfası altında.

Bu yerleşimler teknik olarak mantıklı görünüyor, fakat kaynak PDF render sırasıyla son görsel teyit önerilir.

### ŞABLON_ARTEFAKTI

Kaynak DOCX içinde taşınan fakat nihai yayın için gözden geçirilmesi gereken şablon/Word artefaktları:

- Boş ad/soyad ve tez adı yer tutucuları
- Boş tarih yer tutucusu
- Boş jüri/unvan yer tutucuları
- Bozuk TEŞEKKÜR bookmark alanı

## Denklem Denetimi

Kaynak DOCX’te 151 `oMath` nesnesi ve 65 `oMathPara` konteyneri var. Hedef raporda 118 display math bloğu ve kaba sayımla 309 inline math parçası bulunuyor.

Sonuç:

- Kritik teknik denklemler hedefte mevcut: duty-cycle, L/C/ESR seçimi, $C R_{ESR}=1.59\,\mu$, $2.44\,\text{n}<CL<25.3\,\text{n}$, sensor gain, $G_{vd}(s)$, loop gain, compensator eleman denklemleri, verim hesabı.
- Ancak kaynak denklem nesneleriyle hedef Markdown denklemleri birebir map edilmiş değil.
- Bazı karmaşık kaynak denklemler görsel olarak korunmuş veya normalize edilerek yeniden yazılmış.
- Denklem denetimi bu yüzden genel olarak `KISMİ` kabul edilmeli, ama kritik tasarım denklemleri korunmuş görünüyor.

## Görsel Denetimi

Görsel durumu güçlü:

- Kaynak DOCX medya sayısı: 53
- Hedefte benzersiz bağlı DOCX medya: 53
- Hedefte toplam görsel referansı: 54
- `image38.png` iki farklı bağlamda kullanıldığı için toplam referans 54.
- `image12.png`, `image13.png`, `image30.png`, `image32.png`, `image33.png` artık raporda doğrudan bağlı ve çok küçük oldukları için ölçeklenmiş.

Kırık görsel referansı saptanmadı.

## Tablo Denetimi

Kaynakta 28 Word tablosu var. Hedefte 10 Markdown table block ve 100 tablo satırı var. Bu birebir eksiklik anlamına gelmeyebilir, çünkü kaynak Word tablolarının bir bölümü denklem/layout taşıyıcısı gibi kullanılmış.

Risk:

- Bazı kaynak tablo hücrelerindeki denklem dizilimi Markdown’da yeniden yorumlanmış olabilir.
- Özellikle güç katı hesapları, compensator çözümü ve simülasyon parametre tablosu PDF ile son kez görsel olarak karşılaştırılmalı.

## Referanslar ve Ekler

Referanslar hedefte temiz formatta mevcut. Ekler de aktarılmış:

- EK-1 sığaç verisayfası: `image52.png`
- EK-2 genel görünüm: `image53.png`

Risk:

- Kaynak OOXML section attribution `image52.png` için EK-2 altında sayım veriyor; hedef semantik olarak EK-1 altında gösteriyor. Bu büyük olasılıkla doğru, ama PDF render ile teyit edilmeli.
- Third-party PDF/TXT dosyaları repo içinde source/reference material olarak duruyor; lisans/dağıtım kararı ayrıca ele alınmalı.

## Yeniden Kullanılabilir Mevcut İçerik

Körlemesine silinmemesi gereken ve sonraki migration adımlarında yeniden kullanılabilecek içerikler:

| İçerik | Değerlendirme |
|---|---|
| `docs/full-report.md` | Ana teknik gövde olarak yeniden kullanılabilir; gap’ler düzeltme odaklı. |
| `README.md` | Teknik landing page olarak güçlü; full report’a doğru bağlanıyor. |
| `docs/index.md` | Navigasyon girişi olarak yararlı; sadece küçük medya notu güncel değil. |
| `docs/verification-summary.md` | Verification tablosu iyi; kaynak kapsam boşluklarını açık bırakıyor. |
| `docs/source-map.md` | Görsel ve bölüm haritası yararlı; küçük güncellemelerle ana izleme dosyası olabilir. |
| `docs/assets/full-report/` | Tam raporda kullanılan semantik, temiz adlandırılmış medya seti. |
| `docs/assets/docx-media/media/` | Tam DOCX kaynak medya seti; 53 dosyanın tamamı semantik asset manifestiyle izleniyor. |
| `docs/assets/docx-media/raw/` | Ham medya kopyası; doğrulama/yeniden üretim için korunmalı. |
| `images/readme/` | Temiz adlandırılmış görseller; landing page veya bölünmüş docs için kullanılabilir. |
| `images/docx_extracted/` | Eski kısmi çıkarım; legacy karşılaştırma için tutulabilir. |
| `ekran gorüntüleri/` | Orijinal simülasyon ekran görüntüleri; kaynak kanıt olarak korunmalı. |
| `LTspice_AveragedSwitchModelingSimulation/` | Simülasyon kaynakları ve sonuçları; buck dosyaları ana kanıt, diğer topolojiler eğitim/referans olarak ayrıştırılmalı. |
| `tools/convert_docx_to_markdown.py` | Tekrar üretilebilir dönüşüm altyapısı için kullanılabilir. |
| `tools/check_docs_quality.py` | Link/görsel/encoding QA için kullanılabilir; DOCX media coverage kontrolü içeriyor. |

## Öncelikli Gap Listesi

Bu promptta düzeltme yapılmadı, ancak sonraki çalışma için en önemli audit bulguları:

1. `docs/index.md` küçük medya notu güncellenmeli.
2. Kaynak DOCX’teki Word bookmark hatası kaynağın içinde düzeltilmeli veya hedefte bilinçli olarak “kaynak artefaktı” şeklinde notlanmalı.
3. Kapak/onay şablon alanları nihai yayın için doldurulmalı veya template olduğu açıkça belirtilmeli.
4. Denklem aktarımı için source-to-target equation map gerekirse ayrı bir audit dosyasıyla detaylandırılmalı.
5. Word table -> Markdown table karşılaştırması özellikle güç katı ve compensator bölümlerinde PDF render ile yapılmalı.
6. Ripple/verimlilik ve EK görsellerinin semantik konumu PDF render ile teyit edilmeli.
7. Third-party PDF/TXT dosyaları için lisans/dağıtım kararı verilmeli.

## Oluşturulan Audit Çıktıları

- `docs/migration-gap-report.md`
- `docs/migration-coverage.csv`

Bu dosyalar yalnız audit amaçlıdır; ana içerik dosyalarında bu prompt kapsamında değişiklik yapılmadı.
