gokberkgucin/MIT_Buck_Converter_Design_TAMAMLANDI/REPO_AUDIT.md

# Repo Audit

Bu dosya, repoyu kaynak DOCX belgesinden GitHub'da okunabilir bir teknik proje reposuna donusturmeden onceki mevcut durumu kaydeder. Bu audit buyuk icerik tasima islemi degildir; hangi parcalar korunacak, hangileri yeniden yazilacak ve hangi bosluklar kapatilacak sorularina cevap verir.

## Source of Truth

Celiski durumunda oncelik sirasi:

1. `Birinci_donem_Buck_Converter_Serbest_Projesi.docx`
2. Yereldeki gorseller, simulasyon ekran goruntuleri ve LTspice dosyalari
3. Mevcut repo icerigi

Mevcut `README.md`, kaynak belgeyle celistiginde kazanacak kaynak degildir. README yalnizca gecici ozet ve repo giris noktasi olarak ele alinmalidir.

## Mevcut Repo Yapisi Ozeti

Repo kokunde tamamlanmis bir senkron buck converter lisans/proje calismasina ait rapor, kaynak dokumanlar, LTspice devreleri ve gorsel kanitlar bulunuyor.

Dosya tipi dagilimi:

| Tur | Adet | Not |
|---|---:|---|
| `.png` | 30 | DOCX'ten cikarilmis veya README icin adlandirilmis denklemler/gorseller |
| `.jpg` | 26 | Simulasyon ekran goruntuleri ve README kopyalari |
| `.asc` | 16 | LTspice sematikleri |
| `.raw` | 14 | LTspice sonuc dosyalari; biri cok buyuk |
| `.asy` | 13 | LTspice sembolleri |
| `.log` | 8 | LTspice log dosyalari |
| `.pdf` | 4 | Ana rapor, MIT sartnamesi, kaynak kitap, datasheet |
| `.lib` | 2 | LTspice kutuphaneleri |
| `.txt` | 2 | PDF metin cikarimlari |
| `.plt` | 1 | LTspice plot ayari |
| `.net` | 1 | LTspice netlist |
| `.md` | 1 | Mevcut README |
| `.docx` | 1 | Ana kaynak belge |

Ana klasorler:

| Path | Durum | Degerlendirme |
|---|---|---|
| `BOM/` | Bos | Gerekli olabilir, simdilik silinmemeli; ileride BOM veya parca listesi icin kullanilabilir. |
| `ekran gorüntüleri/` | 17 dosya | LTspice/simulasyon kanitlari var; korunmali fakat GitHub uyumlu adlarla yeniden kopyalanmali veya tasinmali. |
| `foto/` | Alt klasorleri bos | Defter/fiziksel goruntu akisi icin ayrilmis gorunuyor; simdilik korunabilir, bos kalirsa ileride kaldirilabilir. |
| `images/docx_extracted/` | 15 dosya | DOCX'ten cikarilmis gorsellerin kismi seti; kaynak DOCX'teki tum medya degil. |
| `images/readme/` | 24 dosya | GitHub icin adlandirilmis ve kullanilabilir gorsel seti; korunmali, yeni dokumantasyonda ana gorsel kaynagi olabilir. |
| `images/odt_embedded/` | Bos | Mevcut migration icin kanit yok; ileride temizlenebilir. |
| `LTspice_AveragedSwitchModelingSimulation/` | 55 dosya | Simulasyon kaynaklari ve sonuclari; korunmali, fakat daha okunur `simulations/ltspice/` yapisina tasinmasi planlanmali. |
| `references/` | Bos; `references/pdfs/` de bos | Mevcut referans PDF'leri kokte duruyor; klasor amacina uygun degil, yeniden duzenlenmeli. |
| `tracking/` | Bos | Migration/ilerleme kaydi icin kullanilabilir ama mevcut haliyle bos. |

## Ana Dosyalar

| Path | Rol | Audit karari |
|---|---|---|
| `Birinci_donem_Buck_Converter_Serbest_Projesi.docx` | Ana kaynak belge | Mutlaka korunacak. Markdown'a donusumde birincil kaynak. |
| `Birinci_donem_Buck_Converter_Serbest_Projesi.pdf` | DOCX'in okunabilir/render edilmis rapor kopyasi | Korunacak; GitHub'da nihai rapor indirme linki olarak kalabilir. |
| `README.md` | Kisa mevcut ozet | Yeniden yazilacak; uzun rapor yerine navigasyon ve proje ozeti olmali. |
| `G5_mit6_622_s23_designproj.pdf` | MIT proje sartnamesi | Korunacak; `docs/references.md` veya `references/` altinda linklenmeli. |
| `G5_mit6_622_s23_designproj.txt` | Sartname metin cikarimi | Arama ve referans icin korunabilir; konumu netlestirilmeli. |
| `G31_Robert_Erikson_fundamentals-of-power-electronics-3n_2020.pdf` | Kaynak kitap | Korunacaksa boyut/telif riski not edilmeli; GitHub reposunda tutulmasi yeniden degerlendirilmeli. |
| `G31_Robert_Erikson_fundamentals-of-power-electronics-3n_2020.txt` | Kaynak kitap metin cikarimi | Arama icin yararli fakat telif/boyut riski var; kaynak klasorune alinmali veya repo disi tutulmali. |
| `G32_lm5146-q1.pdf` | LM5146-Q1 datasheet | Korunacak; proje gelecegi ve ikinci iterasyon notlari icin referans. |

## Korunacak Mevcut Parcalar

- `Birinci_donem_Buck_Converter_Serbest_Projesi.docx`
- `Birinci_donem_Buck_Converter_Serbest_Projesi.pdf`
- `LTspice_AveragedSwitchModelingSimulation/` altindaki `.asc`, `.asy`, `.lib`, `.plt`, `.net`, `.log` dosyalari
- `images/readme/` altindaki temiz adlandirilmis gorseller
- `images/docx_extracted/` altindaki DOCX kaynakli gorseller
- `ekran gorüntüleri/` altindaki orijinal simulasyon ekran goruntuleri
- `G5_mit6_622_s23_designproj.pdf`
- `G32_lm5146-q1.pdf`
- Mevcut kaynak PDF/TXT dosyalari, telif ve boyut karari verilene kadar

## Gelistirilecek veya Yeniden Yazilacak Parcalar

- `README.md`: Su an kisa ozet seviyesinde. Yeni durumda kisa proje girisi, teknik hedefler, repo navigasyonu, ana bulgular ve dokumantasyon linkleri icermeli; raporun tamamini icermemeli.
- `images/readme/`: Iyi bir baslangic seti var ama hangi DOCX bolumunde hangi gorselin kullanilacagi haritalanmali.
- `LTspice_AveragedSwitchModelingSimulation/`: Dosya isimleri korunarak daha temiz bir simulasyon dizinine tasinmasi planlanmali; kaynak devreler ile agir sonuc dosyalari ayrilmali.
- `references/`: Su an bos. Kokteki referans PDF/TXT dosyalari icin mantikli hedef klasor olmali.
- Bos klasorler: `BOM/`, `foto/`, `tracking/`, `images/odt_embedded/`, `references/pdfs/` ancak icerik tasima kararindan once silinmemeli.

## Silme veya Yeniden Adlandirma Adaylari

Henuz silme yapilmadi. Asagidaki kararlar sonraki migration adimlarinda verilmeli:

| Aday | Oneri | Gerekce |
|---|---|---|
| `ekran gorüntüleri/` | Orijinali koru; GitHub uyumlu kopyalari `assets/screenshots/` altina al | Path icinde bosluk ve Turkce karakter var. |
| `LTspice_AveragedSwitchModelingSimulation/` | `simulations/ltspice/` altina tasima planla | Uzun ve karisik ad; kaynak/sonuc ayrimi yok. |
| `SyncBuck_switching_CL.raw` | Korunacaksa Git LFS veya release artifact degerlendirilmelidir | Yaklasik 523 MB; GitHub icin cok agir. |
| `images/docx_extracted/` | Tam medya cikarimi tamamlanana kadar koru | DOCX'te 53 medya var, bu klasorde yalnizca 15 dosya var. |
| `images/readme/` | Korunacak; gerekirse `assets/figures/` altina tasinacak | Temiz adlandirilmis ve hash olarak bazi kaynaklarla ayni gorselleri iceriyor. |
| Bos klasorler | Migration sonunda tekrar degerlendir | Simdilik kayip riski yaratmamak icin dokunulmadi. |

## DOCX Baslik Yapisi

Kaynak DOCX'te baslik yapisi su sekilde cikti. TOC icindeki sayfa numaralari kaynak belgeden okunmustur.

| DOCX basligi | Seviye | TOC sayfasi | Repo hedefi |
|---|---:|---:|---|
| `ABSTRACT` | H1 | iv | `docs/00-abstract.md` |
| `İÇİNDEKİLER` | H1 | vi | Markdown'da otomatik/elle navigasyon; ayri bolum olarak tasinmasi gerekmiyor |
| `BÖLÜM 1` | Subtitle | 1 | `docs/01-giris.md` icinde ust not olarak |
| `GİRİŞ` | H1 | 1 | `docs/01-giris.md` |
| `Çalışmanın Amacı ve Kapsamı` | H2 | 1 | `docs/01-giris.md#calismanin-amaci-ve-kapsami` |
| `Buck Converter Nedir?` | H2 | 1 | `docs/01-giris.md#buck-converter-nedir` |
| `Güç ve Kontrol Tasarımında İzlenen Yöntem` | H1 | 2 | `docs/02-guc-ve-kontrol-tasarim-yontemi.md` |
| `Frekans Seçim Kuralları ve Hesaplamalar` | H2 | 3 | `docs/02-guc-ve-kontrol-tasarim-yontemi.md#frekans-secim-kurallari-ve-hesaplamalar` |
| `Hesaplamalarda Kullanılacak Parametreler:` | H2 | 5 | `docs/02-guc-ve-kontrol-tasarim-yontemi.md#hesaplamalarda-kullanilacak-parametreler` |
| `Güç Katı Hesaplamaları:` | H1 | 6 | `docs/03-guc-kati-hesaplamalari.md` |
| `Çevirici Durum Denklemleri` | H1 | 12 | `docs/04-cevirici-durum-denklemleri.md` |
| `ESR Etkisi` | H2 | 13 | `docs/04-cevirici-durum-denklemleri.md#esr-etkisi` |
| `Genel Dalga-Biçimleri` | H2 | 14 | `docs/04-cevirici-durum-denklemleri.md#genel-dalga-bicimleri` |
| `kontrolcu tasarımı` | H1 | 16 | `docs/05-kontrolcu-tasarimi.md` |
| `Kontrolcu Hesabı` | H2 | 16 | `docs/05-kontrolcu-tasarimi.md#kontrolcu-hesabi` |
| `Op-amp devresi -gerçeklemesi` | H1 | 32 | `docs/06-opamp-gerceklemesi.md` |
| `Sensor Gain (H(s))` | H2 | 33 | `docs/06-opamp-gerceklemesi.md#sensor-gain-hs` |
| `Compensator  Devresi` | H2 | 34 | `docs/06-opamp-gerceklemesi.md#compensator-devresi` |
| `Benzetim sonuçları` | H1 | 40 | `docs/07-benzetim-sonuclari.md` |
| `Tasarım Gereksinimleri` | H2 | 40 | `docs/07-benzetim-sonuclari.md#tasarim-gereksinimleri` |
| `Benzetimde kullanılan elemanlar ve parametreler` | H2 | 41 | `docs/07-benzetim-sonuclari.md#benzetimde-kullanilan-elemanlar-ve-parametreler` |
| `Çıkış Gücü` | H2 | 43 | `docs/07-benzetim-sonuclari.md#cikis-gucu` |
| `Output Voltage (static requirement):` | H2 | 44 | `docs/07-benzetim-sonuclari.md#output-voltage-static-requirement` |
| `Output Voltage (transient limits):` | H2 | 45 | `docs/07-benzetim-sonuclari.md#output-voltage-transient-limits` |
| `Allowed output voltage ripple (p-p, any R load)` | H2 | 46 | `docs/07-benzetim-sonuclari.md#allowed-output-voltage-ripple-p-p-any-r-load` |
| `Verimlilik` | H2 | 47 | `docs/07-benzetim-sonuclari.md#verimlilik` |
| `Hesaplamaların Doğrulanması` | H2 | 48 | `docs/07-benzetim-sonuclari.md#hesaplamalarin-dogrulanmasi` |
| `PROJENIN GELECEĞİ` | H1 | 49 | `docs/08-projenin-gelecegi.md` |
| `KAYNAKLAR` | H1 | 50 | `docs/references.md` |
| `EKLER` | H2 | 51 | `docs/appendices.md` |
| `EK-1. Sığaç Verisayfası` | H2 | 51 | `docs/appendices.md#ek-1-sigac-verisayfasi` |
| `EK-2. Genel görünüm` | H2 | 51 | `docs/appendices.md#ek-2-genel-gorunum` |

## DOCX Icerik Sinyalleri

Kaynak DOCX yapisal olarak yalnizca metinden ibaret degil:

- 814 paragraf
- 28 tablo
- 151 inline veya blok matematik nesnesi
- 65 matematik paragrafi
- 55 cizim/drawing nesnesi
- 53 gomulu medya dosyasi

Bu nedenle Markdown migration sirasinda salt metin cikarimi yeterli olmayacak. Denklemler, tablolar ve gorseller tek tek dogrulanmali.

## Mevcut Repo ile Kaynak DOCX Arasindaki Gap Analizi

| Alan | Mevcut repo | Kaynak DOCX | Gap |
|---|---|---|---|
| Genel ozet | `README.md` kisa ozet veriyor | Tam lisans/proje raporu | README raporun neredeyse tamamini kapsamiyor. |
| Baslik yapisi | Markdown bolumleri yok | 8 ana bolum, kaynaklar ve ekler var | `docs/` altinda bolum bazli Markdown dosyalari olusturulmali. |
| Denklem aktarimi | Bazi denklemler `images/readme/` altinda var | 151 matematik nesnesi var | Denklem formatlari eksik; LaTeX mi gorsel mi olacagi secilmeli. |
| Gorseller | `images/readme/` 24 dosya, `images/docx_extracted/` 15 dosya | DOCX icinde 53 medya var | Gorsel seti tam degil; eksikler cikarilmali ve adlandirilmali. |
| Simulasyon kanitlari | `ekran gorüntüleri/` ve LTspice sonuclari var | Benzetim bolumu bunlari acikliyor | Hangi ekran goruntusunun hangi alt basliga ait oldugu haritalanmali. |
| LTspice kaynaklari | `.asc`, `.asy`, `.lib`, `.raw`, `.log` dosyalari var | Rapor hesap dogrulamalarina atif yapiyor | Simulasyon dosyalari bolum bazli aciklanmiyor. |
| Kaynaklar | PDF/TXT kokte ve `references/` bos | Kaynaklar bolumu var | Kaynaklar repo icinde duzenli degil. |
| Ekler | PDF/DOCX icinde ekler var | Sığaç verisayfasi ve genel gorunum ekleri var | `docs/appendices.md` ve asset linkleri eksik. |
| Turkce karakterler | README'de encoding bozulmalari gorunuyor | DOCX'te Turkce karakterler dogru okunabiliyor | Markdown dosyalari UTF-8 olarak yazilmali; link slug'lari sade ASCII olmali. |

## Hash/Duplicate Gorsel Bulgulari

`images/readme/` altindaki 24 dosyanin bir bolumu `images/docx_extracted/` ve `ekran gorüntüleri/` ile birebir ayni hash'e sahip. Bu iyi bir isaret: `images/readme/` GitHub icin temiz adlandirilmis ara katman olarak kullanilabilir.

Ornek birebir eslesmeler:

- `images/readme/output_power_125w.jpg` = `ekran gorüntüleri/01_125W GUC.jpg`
- `images/readme/output_power_55w.jpg` = `ekran gorüntüleri/02_55W.jpg`
- `images/readme/output_ripple.jpg` = `ekran gorüntüleri/cıkış ripple.jpg`
- `images/readme/final_loop_gain.png` = `images/docx_extracted/image27.png`
- `images/readme/type3_frequency_relations.png` = `images/docx_extracted/image1.png`

## Kritik Riskler

- Kayip gorsel riski: DOCX'te 53 medya dosyasi var; repoda temiz adlandirilmis set 24, kismi DOCX cikarimi 15 dosya.
- Bozuk denklem riski: DOCX'te 151 matematik nesnesi var. Markdown'a otomatik aktarimda bosluklar, semboller veya kesirler bozulabilir.
- Turkce karakter riski: Eski dokumantasyon ciktisinda plus/minus, check mark ve delta sembollerinde encoding bozulmalari gorulmustu. Yeni dosyalar UTF-8 kalmali, link slug'lari ASCII olusturulmali.
- Kirik link riski: Dosya adlarinda bosluk, apostrof, Turkce karakter ve parantez var. GitHub linklerinde encoding ve case hassasiyeti kontrol edilmeli.
- Asiri uzun README riski: Tum DOCX README'ye tasinmamalidir. README bir giris ve navigasyon dosyasi olmali; teknik icerik `docs/` altina bolunmeli.
- Buyuk dosya riski: `LTspice_AveragedSwitchModelingSimulation/SyncBuck_switching_CL.raw` yaklasik 523 MB. GitHub icin uygun olmayabilir.
- Telif/boyut riski: Kokteki buyuk kaynak kitap PDF/TXT dosyalari repoda tutulacaksa lisans ve dagitim durumu ayrica degerlendirilmeli.
- LTspice tekrar/karisiklik riski: Klasorde buck projesine ait dosyalarla boost/flyback/SEPIC ornekleri birlikte duruyor. Bunlar egitim/referans olabilir, ama nihai repo yapisinda acik ayrim gerekir.
- Bos klasor riski: Bos klasorler Git'te kalmayabilir. Gerekliyseler `.gitkeep` veya README ile amaclari belirtilmeli.

## Belirsizlikler

- DOCX icindeki 53 gomulu medyanin tamamindan hangileri nihai GitHub dokumantasyonuna alinacak henuz belirlenmedi.
- Denklem aktarim stratejisi henuz kesin degil: LaTeX olarak yeniden yazma, gorsel olarak koruma veya karma yontem secilebilir.
- `G31_Robert_Erikson_fundamentals-of-power-electronics-3n_2020.pdf` ve `.txt` dosyalarinin repoda kalmasi telif ve boyut acisindan onay gerektiriyor.
- Bos klasorlerin proje sahibinin gelecekteki kullanim amacina hizmet edip etmedigi bilinmiyor.
- LTspice `.raw` dosyalarinin tamaminin tekrar uretilebilir olup olmadigi ve hangilerinin kanit olarak zorunlu oldugu henuz dogrulanmadi.
- Mevcut PDF ile DOCX'in birebir ayni revizyon olup olmadigi gorsel render karsilastirmasi ile dogrulanmadi.
