gokberkgucin/MIT_Buck_Converter_Design_TAMAMLANDI/docs/TRANSFER_AUDIT.md

# Transfer Audit

This file is generated by `tools/convert_docx_to_markdown.py`.

## Conversion Summary

- Method used: `pandoc`
- Source DOCX: `Birinci_donem_Buck_Converter_Serbest_Projesi.docx`
- Target Markdown: `docs/full-report.md`
- Original copies: `docs/originals/birinci-donem-buck-converter-serbest-projesi.docx`, `docs/originals/birinci-donem-buck-converter-serbest-projesi.pdf`

## Required Metrics

- Source heading count: `32`
- Target heading count: `28`
- Source extracted media count: `53`
- Target linked image count: `54` total references / `53` unique DOCX media targets
- Source table count: `28`
- Target detected table count: `14`
- Source list paragraph count: `27`
- Target detected list item count: `98`
- Source OOXML math object count: `151`
- Target detected math expression count: `59`
- Source drawing count: `55`

## Source Headings

- H1 `Balk1`: ABSTRACT
- H1 `Balk1`: İÇİNDEKİLER
- H2 `Altyaz`: BÖLÜM 1
- H1 `Balk1`: GİRİŞ
- H2 `Balk2`: Çalışmanın Amacı ve Kapsamı
- H2 `Balk2`: Buck Converter Nedir?
- H1 `Balk1`: Güç ve Kontrol Tasarımında İzlenen Yöntem
- H2 `Balk2`: Frekans Seçim Kuralları ve Hesaplamalar
- H2 `Balk2`: Hesaplamalarda Kullanılacak Parametreler:
- H1 `Balk1`: Güç Katı Hesaplamaları:
- H1 `Balk1`: Çevirici Durum Denklemleri
- H2 `Balk2`: ESR Etkisi
- H2 `Balk2`: Genel Dalga-Biçimleri
- H1 `Balk1`: kontrolcu tasarımı
- H2 `Balk2`: Kontrolcu Hesabı
- H1 `Balk1`: Op-amp devresi -gerçeklemesi
- H2 `Balk2`: Sensor Gain (H(s))
- H2 `Balk2`: Compensator  Devresi
- H1 `Balk1`: Benzetim sonuçları
- H2 `Balk2`: Tasarım Gereksinimleri
- H2 `Balk2`: Benzetimde kullanılan elemanlar ve parametreler
- H2 `Balk2`: Çıkış Gücü
- H2 `Balk2`: Output Voltage (static requirement):
- H2 `Balk2`: Output Voltage (transient limits):
- H2 `Balk2`: Allowed output voltage ripple (p-p, any R load)
- H2 `Balk2`: Verimlilik
- H2 `Balk2`: Hesaplamaların Doğrulanması
- H1 `Balk1`: PROJENIN GELECEĞİ
- H1 `Balk1`: KAYNAKLAR
- H2 `Balk2`: EKLER
- H2 `Balk2`: EK-1. Sığaç Verisayfası
- H2 `Balk2`: EK-2. Genel görünüm

## Unlinked Media

No unlinked media detected by basename comparison. Manual follow-up after README/docs QA confirmed that `image12.png`, `image13.png`, `image30.png`, `image32.png`, and `image33.png` are also linked in `docs/full-report.md`.

## Unresolved Equations

Potential unresolved equations were detected by comparing OOXML math object count with Markdown math markers. These require manual review:

- equation-001: Giriş Gerilimi Vin,max= 36 V
- equation-002: Vin,min= 24 V
- equation-003: Çıkış Gücü= 50W-125W
- equation-004: Çıkış Gerilimi Vo= 14V
- equation-005: Çıkış Akımı Io,min=50W14V = 3.571 A
- equation-006: Çıkış Akımı Io,max=125W14V = 8.92 A
- equation-007: Çıkış Gerilimi Tepeden tepeye dalgalanma ∆Vo =0.100 V
- equation-008: Yük Direnci Rload,min=VoIo,max = 14V8.92 A = 1.569 Ω
- equation-009: Yük Direnci Rload,max=VoIo,min = 14V3.57 A = 3.921 Ω
- equation-010: DutyCycle D'nin
- equation-011: değer aralığını
- equation-012: belirlemek
- equation-013: VoVin,max≤ D ≤VoVin,min
- equation-014: 14V36V≤ D ≤14V24V
- equation-015: fs= 100kHz
- equation-016: ∆IL
- equation-017: ∆IL= 0.2×Io,max
- equation-018: =0.2×8.92
- equation-019: =1.784 A
- equation-020: OOXML math object without extractable plain text
- equation-021: Io,max
- equation-022: L
- equation-023: L =Vo×1-D,min∆IL×fS =14×1-0.38880.2×8.92 × 100k= 47.94μH
- equation-024: Cmin = 1-D,min8*L*∆Vo/Vo*fs2
- equation-025: = 1-0.38888*47.94μ*(0.01/14)*(100k)2
- equation-026: C≥ 22.3μ F
- equation-027: resr
- equation-028: ESR≤∆Vo∆IL
- equation-029: ESR≤0.11.784
- equation-030: ESR≤56m Ω
- equation-031: C≥ 22.3μ F
- equation-032: L =47.94μH
- equation-033: ESR≤56m Ω
- equation-034: μ
- equation-035: 56m Ω
- equation-036: μ
- equation-037: μ
- equation-038: fo = 12√L*C
- equation-039: ∆IL =Vo×1-D,minL×fS =14×1-0.388847.42u × 100k= 47.94μH
- equation-040: ∆IL = 1.714 A
- equation-041: ESR≤∆Vo∆IL
- equation-042: ∆IL/2
- equation-043: 1.714 /2
- equation-044: 8.92
- equation-045: ∆IL/2
- equation-046: 3.571
- equation-047: 1.714 /2
- equation-048: IL,RMS =IL2+ ∆IL232
- equation-049: IL,RMS =10.6342+ 1.714232
- equation-050: IL,RMS = 10.645 A
- equation-051: ∆Vo= Vo*1-D,min8L *C*fs2
- equation-052: = 14*1-0.3888 8*47.94μ*(82μ )*(100k)2
- equation-053: ∆Vo
- equation-054: IC,RMS
- equation-055: IC,RMS =IC2+ ∆IC232
- equation-056: IC,RMS =02+ 1.714232
- equation-057: IC,RMS = 0.4947A
- equation-058: Giriş Gerilimi Vs,max= 36 V
- equation-059: Giriş Gerilimi Vs,min= 24 V
- equation-060: Çıkış Gücü Pmax= 125W
- equation-061: Çıkış Gücü Pin= 50W
- equation-062: Çıkış Gerilimi Vo= 14V
- equation-063: Çıkış Gerilimindeki Tepeden tepeye dalgalanma ∆Vo =27mV
- equation-064: Rload,min= 1.569 Ω
- equation-065: Rload,max=3.921 Ω
- equation-066: vg,
- equation-067: İload
- equation-068: 1,814
- equation-069: vd
- equation-070: dt
- equation-071: dt
- equation-072: Gvds=VD×1+sⅇsr1+1Q×sw0+sw02
- equation-073: f0=12πCL
- equation-074: f0=12π82µ×49.42µ = 2.5kHz
- equation-075: ESR Sıfırı frekansı fesr=12π×82µ×19.39m = 100kHz
- equation-076: Qloss=L/CResr + Rl =49.42µ/82µ19.39m+30m
- equation-077: Qloss = 15.718 veya 23.92dB
- equation-078: R√L/C
- equation-079: 1,569√ 49,42µ82µ
- equation-080: Qloss x Qload Qloss + Qload
- ... 12 more potential unresolved equations

## Unresolved Tables And Lists

- 14 source table(s) may need manual review (source=28, target_detected=14).

## Broken Character Check

No common mojibake patterns detected.

## Empty Subheadings

- `# GİRİŞ`
- `# Benzetim sonuçları`
- `## EKLER`
- `## EK-1. Sığaç Verisayfası`

## Manual Fix Sections

- docs/full-report.md: Control/Kontrolcu Tasarimi equations and loop-gain derivations
- docs/full-report.md: Op-amp compensator component equations
- docs/full-report.md: Benzetim sonuclari image captions and LTspice evidence mapping
- docs/full-report.md: Kaynaklar and ekler
- docs/full-report.md: empty heading backfill

## Pandoc Output

### stderr

```text
[WARNING] Could not convert TeX math \frac{Vo}{Vin,max} \leq \ D\  \leq \frac{Vo}{Vin,min}, rendering as TeX
[WARNING] Could not convert TeX math \frac{14V}{36V} \leq \ D\  \leq \frac{14V}{24V}, rendering as TeX
[WARNING] Could not convert TeX math L\  = \frac{Vo \times (1 - D,min)}{\mathrm{\Delta}I_{L} \times f_{S}}\  = \frac{14 \times (1 - 0.3888)}{0.2 \times 8.92\  \times \ 100k} = \ 47.94\mu H, rendering as TeX
[WARNING] Could not convert TeX math C_{\min}\  = \ \frac{(1 - D,min)}{8*L*(\mathrm{\Delta}Vo/Vo)*{fs}^{2}}, rendering as TeX
[WARNING] Could not convert TeX math = \ \frac{(1 - 0.3888)}{8*47.94\mu*(0.01/14)*({100k)}^{2}}
  , rendering as TeX
[WARNING] Could not convert TeX math {ESR \leq \frac{\mathrm{\Delta}Vo}{\mathrm{\Delta}I_{L}}
  }{ESR \leq \frac{0.1}{1.784}
  }, rendering as TeX
[WARNING] Could not convert TeX math \mathrm{\Delta}I_{L}\  = \frac{Vo \times (1 - D,min)}{L \times f_{S}}\  = \frac{14 \times (1 - 0.3888)}{47.42u\  \times \ 100k} = \ 47.94\mu H
  , rendering as TeX
[WARNING] Could not convert TeX math ESR \leq \frac{\mathrm{\Delta}Vo}{\mathrm{\Delta}I_{L}}, rendering as TeX
[WARNING] Could not convert TeX math {I_{L,RMS}\  = \sqrt{{I_{L}}^{2} + {\ \left( \frac{\frac{\mathrm{\Delta}I_{L}}{2}}{\sqrt{3}} \right)}^{2}}
  }{I_{L,RMS}\  = \sqrt{{10.634}^{2} + {\ \left( \frac{\frac{1.714}{2}}{\sqrt{3}} \right)}^{2}}}, rendering as TeX
[WARNING] Could not convert TeX math \mathrm{\Delta}Vo = \ \frac{Vo*(1 - D,min)}{8L\ *C_{}*{fs}^{2}}, rendering as TeX
[WARNING] Could not convert TeX math = \ \frac{14*(1 - 0.3888)}{\ 8*47.94\mu*(82\mu\ )*({100k)}^{2}}
  , rendering as TeX
[WARNING] Could not convert TeX math {I_{C,RMS}\  = \sqrt{{I_{C}}^{2} + {\ \left( \frac{\frac{\mathrm{\Delta}I_{C}}{2}}{\sqrt{3}} \right)}^{2}}
  }{I_{C,RMS}\  = \sqrt{0^{2} + {\ \left( \frac{\frac{1.714}{2}}{\sqrt{3}} \right)}^{2}}
  }{I_{C,RMS}\  = \ 0.4947A}, rendering as TeX
[WARNING] Could not convert TeX math \ \frac{1}{2\pi\ x\ fL\ x\ C2}, rendering as TeX
[WARNING] Could not convert TeX math \ \frac{1}{2\pi\ x\ fL}, rendering as TeX
[WARNING] Could not convert TeX math \mathbf{\ }\frac{\mathbf{1}}{\mathbf{2}\mathbf{\pi\ x\ 1k}}, rendering as TeX
```
