gokberkgucin/MIT_Buck_Converter_Design_TAMAMLANDI/ekran gorüntüleri/01_125W GUC.jpg

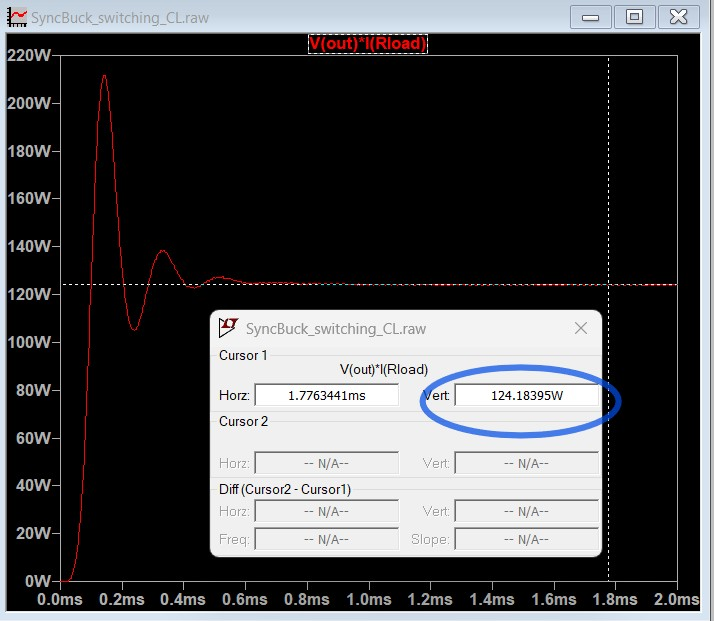
ekran gorüntüleri/01_125W GUC.jpg
