gokberkgucin/MIT_Buck_Converter_Design_TAMAMLANDI/ekran gorüntüleri/01_uncompensated loop gain Tu(s).jpg

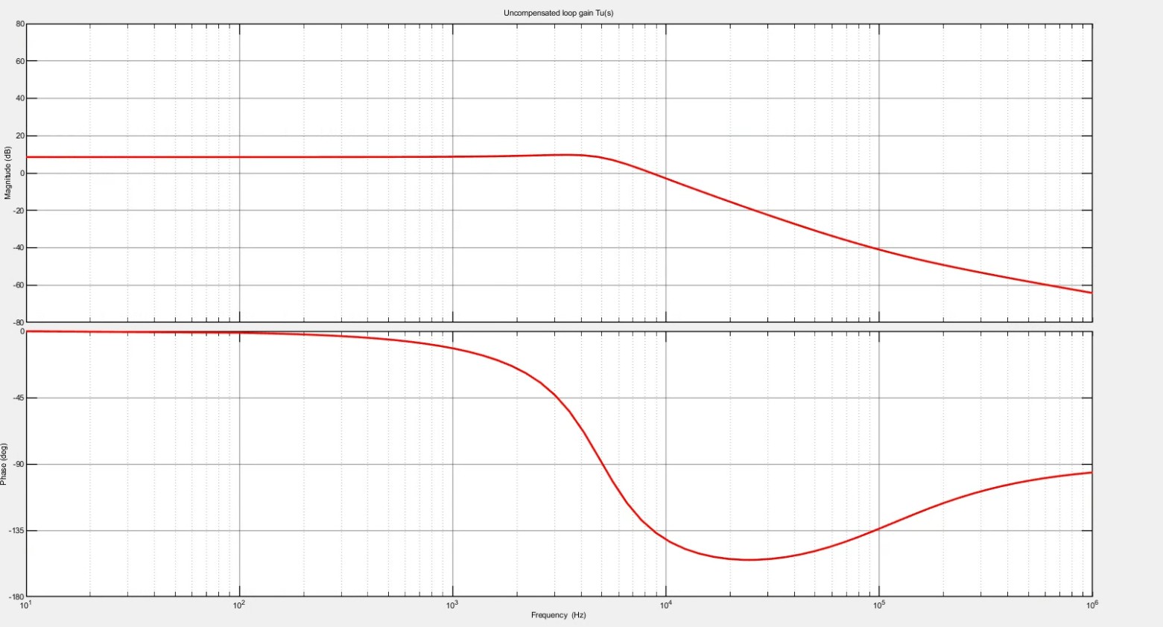
ekran gorüntüleri/01_uncompensated loop gain Tu(s).jpg
