gokberkgucin/MIT_Buck_Converter_Design_TAMAMLANDI/ekran gorüntüleri/02_55W.jpg

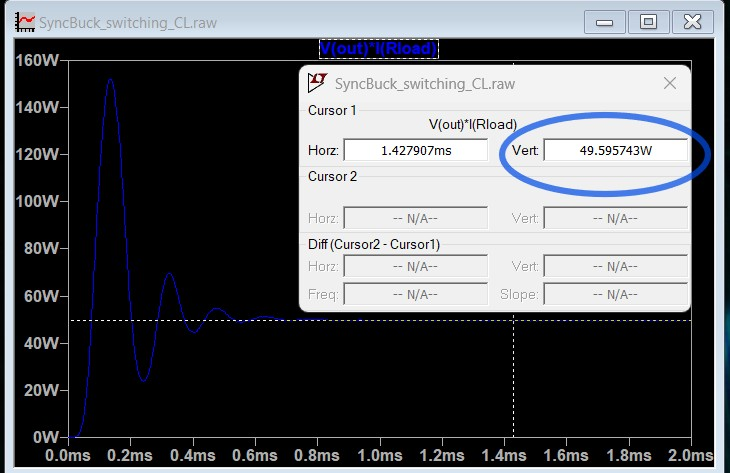
ekran gorüntüleri/02_55W.jpg
