gokberkgucin/MIT_Buck_Converter_Design_TAMAMLANDI/ekran gorüntüleri/02_uncompensated loop gain Tu(s).jpg

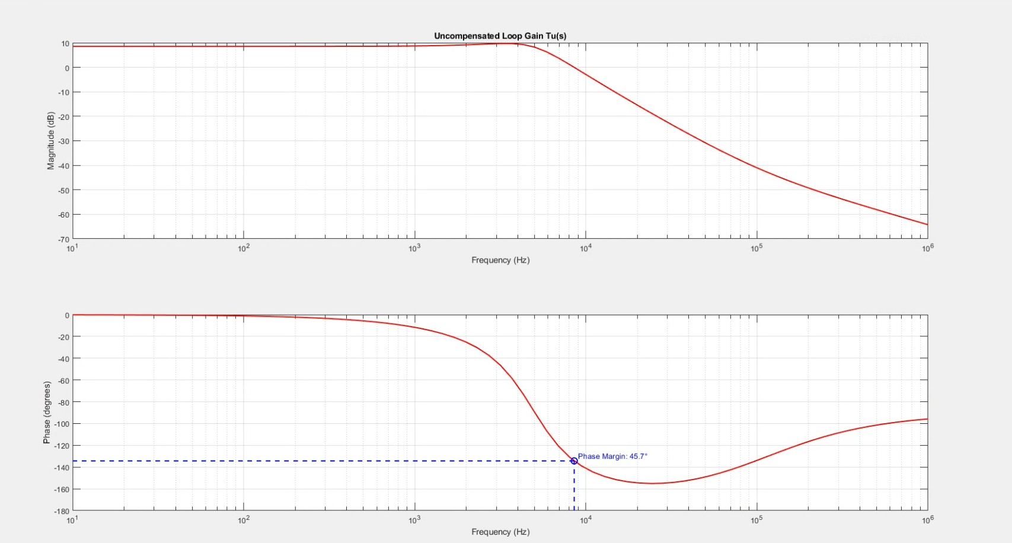
ekran gorüntüleri/02_uncompensated loop gain Tu(s).jpg
