gokberkgucin/MIT_Buck_Converter_Design_TAMAMLANDI/ekran gorüntüleri/36v giriş, iload 1A, R =1.569Ohm giriş gücü.jpg

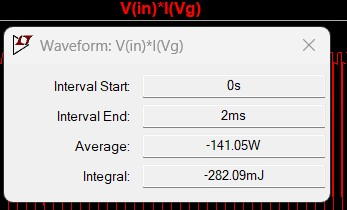
ekran gorüntüleri/36v giriş, iload 1A, R =1.569Ohm giriş gücü.jpg
