gokberkgucin/MIT_Buck_Converter_Design_TAMAMLANDI/ekran gorüntüleri/Ekran görüntüsü 2025-01-08 015357.jpg

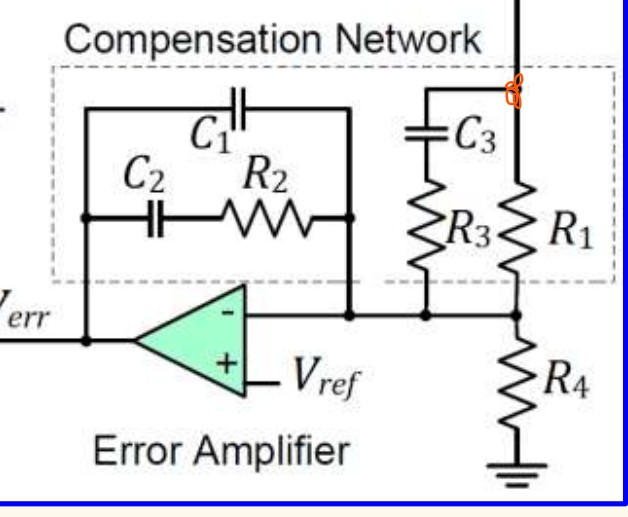
ekran gorüntüleri/Ekran görüntüsü 2025-01-08 015357.jpg
