gokberkgucin/MIT_Buck_Converter_Design_TAMAMLANDI/ekran gorüntüleri/Gcs .jpg

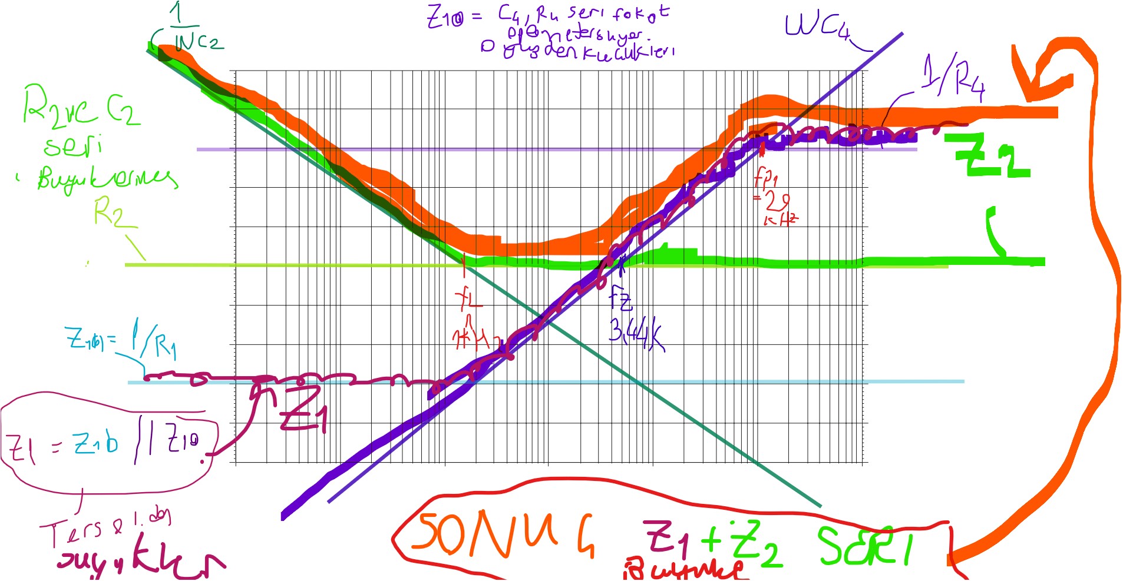
ekran gorüntüleri/Gcs .jpg
