gokberkgucin/MIT_Buck_Converter_Design_TAMAMLANDI/ekran gorüntüleri/opamp gain-freq.jpg

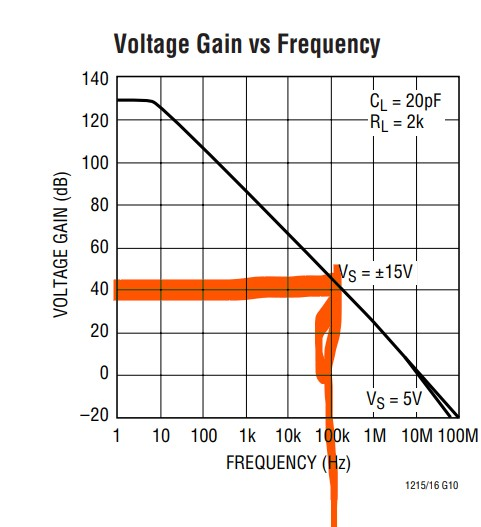
ekran gorüntüleri/opamp gain-freq.jpg
