gokberkgucin/MIT_Buck_Converter_Design_TAMAMLANDI/ekran gorüntüleri/Phase margin 42 çıktı dikkat.jpg

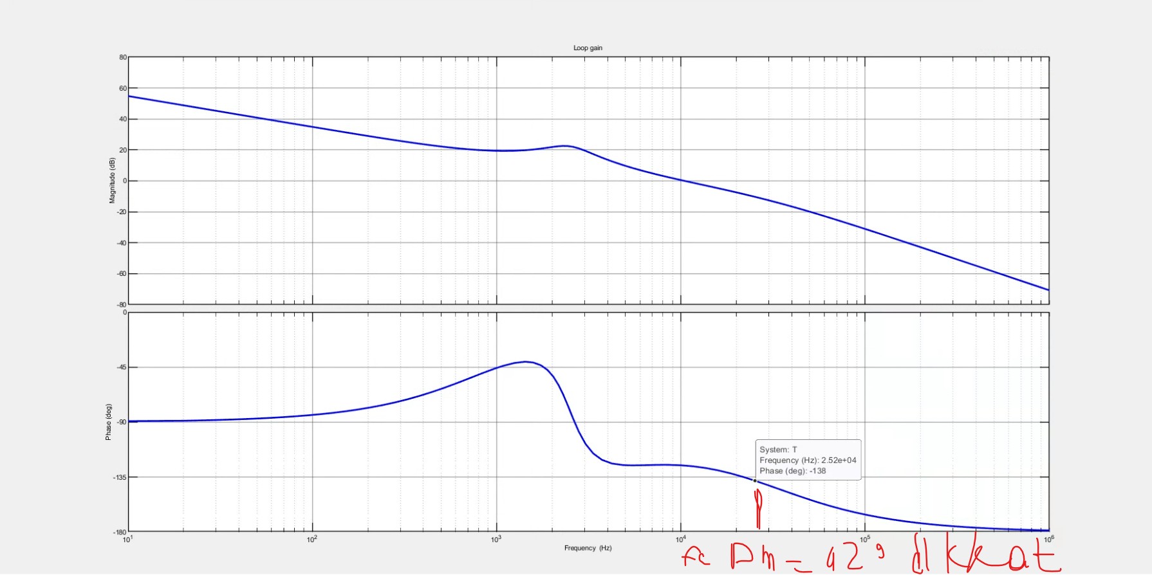
ekran gorüntüleri/Phase margin 42 çıktı dikkat.jpg
