gokberkgucin/MIT_Buck_Converter_Design_TAMAMLANDI/ekran gorüntüleri/pid'li fl 2khz.jpg

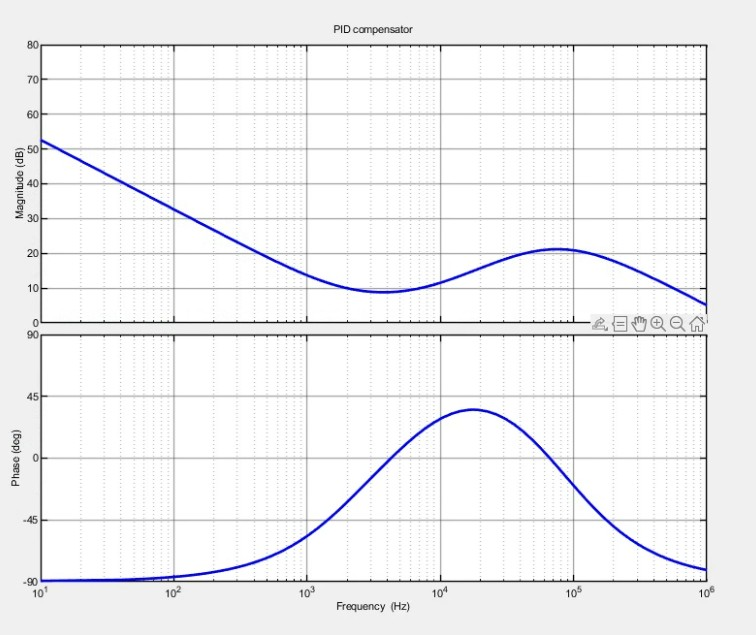
ekran gorüntüleri/pid'li fl 2khz.jpg
