gokberkgucin/MIT_Buck_Converter_Design_TAMAMLANDI/ekran gorüntüleri/Çıkış Sığacı 02.jpg

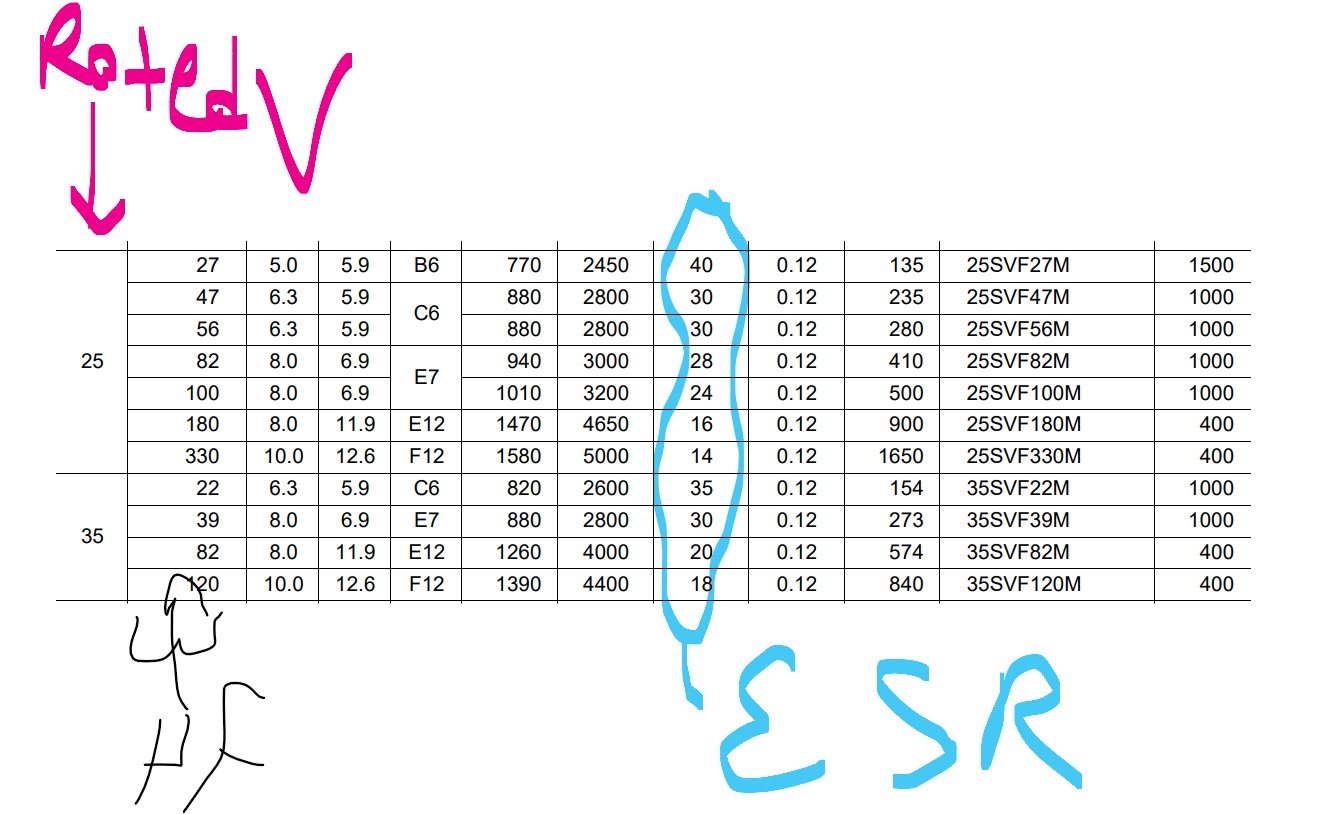
ekran gorüntüleri/Çıkış Sığacı 02.jpg
