gokberkgucin/MIT_Buck_Converter_Design_TAMAMLANDI/LM5146_quickstart_calculator_revB1.xlsm

Sheet: Design Regulator
LM(2)5145/46-Q1 DC-DC Controller Design Tool
About |  | xx (http://www.ti.com/pol) |  |  | = Input Box |  | TERMS OF USE
Step 1: Operating Specifications
 |  |  | Input Voltage ‒ Min, VIN(min) | 24 | V
 |  |  | Input Voltage ‒ Nom, VIN(nom) | 30 | V
 |  |  | Input Voltage ‒ Max, VIN(max) | 36 | V
 |  |  | Output Voltage, VOUT | 14 | V
 |  |  | Maximum Output Current, IOUT | 9 | A
 |  |  | Free-running Switching Frequency, FSW | 332 | kHz
 |  |  | SYNC Frequency (if used), FSW-SYNC | 332 | kHz
 |  |  | Frequency Set Resistor, RRT | 30.1 | kΩ
Step 2: Filter Inductor
 |  |  | Recommended Filter Inductance | 7.5 | µH
 |  |  | Inductance, LO | 6.8 | µH
 |  |  | Inductor DCR | 0.88 | mΩ
 |  |  | Pk-to-Pk Ripple Current at VIN(nom), DIL | 3.4 | APK-PK
 |  |  | Inductor Ripple Current as a % of Max IOUT | 37.47754558 | %
 |  |  | Estimate Core Loss at VIN(nom) | 0.2 | W
Step 3: RDS(on) or Shunt-Based Current Limit
 |  |  | Shunt, RS | 6 | mΩ |  |  | \
 |  |  | Required Current Limit Setpoint | 13 | A
 |  |  | Current Limit Set Resistor, RILIM | 562 | Ω
 |  |  | Min Inductor Sat Current, IL(SAT) | 18.0 | A
 |  |  | Power Loss in RS at Full Load, Max VIN | 0.18 | W
Step 4: Output Capacitance
 |  |  | Output Voltage Ripple Specification | 100 | mVPK-PK
 |  |  | Minimum Ideal Output Capacitance | 12.69946951 | µF
 |  |  | Total Output Capacitance (Derated), COUT | 70 | µF
 |  |  | Maximum Permitted ESR | 29.15539924 | mΩ
 |  |  | Output Capacitor ESR | 0.28 | mΩ
 |  |  | Resulting Output Voltage Ripple | 18.16666516 | mVPK-PK
 |  |  | Output Capacitor Ripple Current | 1.0 | ARMS
Step 5: Input Capacitance
 |  |  | Input Voltage Ripple Specification | 240 | mVPK-PK
 |  |  | Minimum Ideal Input Capacitance | 28.17249709 | µF
 |  |  | Total Input Capacitance (Derated), CIN | 30 | µF
 |  |  | Maximum Permitted ESR | 1.368084739 | mΩ
 |  |  | Input Capacitor ESR | 1 | mΩ
 |  |  | Resulting Input Voltage Ripple | 236.0664663 | mVPK-PK
 |  |  | Input Capacitor Ripple Current | 4.5 | ARMS
Step 6: Soft-start, UVLO
 |  |  | Soft-Start Time, tSS | 4 | ms
 |  |  | Soft-Start Capacitance, CSS | 47 | nF
 |  |  | Input Voltage UVLO Turn-On | 30 | V
 |  |  | Input Voltage UVLO Turn-Off | 28 | V
 |  |  | UVLO Upper Resistor, RUV1 | 200 | kΩ
 |  |  | UVLO Lower Resistor, RUV2 | 8.25 | kΩ
If the SYNC feature is not required, connect SYNCIN to GND
or VCC for diode emulation or FPWM modes, respectively
Step 7: Compensation Design
 |  |  | LC Complex Pole Frequency | 7.3 | kHz
 |  |  | ESR Zero Frequency | 8120.150167 | kHz
 |  |  | Desired Crossover Frequency | 35 | kHz
 |  |  | Appropriate Midband Gain | 0.32 | V/V
 |  |  | Upper Feedback Resistor, RFB1 | 26.4 | kΩ
 |  |  | Lower Feedback Resistor, RFB2 | 1.58 | kΩ
 |  |  | Actual Output Voltage, VOUT | 14.167 | V
Pole & Zero Placement |  |  | FZ1 | 5.1 | kHz
Baseline P/Z Frequencies: |  |  | FZ2 | 6.6 | kHz
 |  |  | FP1 | 8120.150167 | kHz
 |  |  | FP2 | 166 | kHz
Compensation Components
 | Calculated / | Std Values | Selected |  | Actual P/Z Frequencies
RC1 | 8.4 | 8.45 | 6.65 | kΩ | 5.1 | kHz (FZ1)
CC1 | 3690.977349 | 3900 | 4700 | pF | 5.9 | kHz (FZ2)
CC2 | 117.166563 | 120 | 120 | pF | 207.2329991 | kHz (FP1)
RC2 | 21.36653559 | 21.5 | 768 | Ω | 204.5344282 | kHz (FP2)
CC3 | 917.32232 | 1000 | 1000 | pF
Efficiency / Power Loss Analyzer
Step 8: Efficiency
 |  |  | High-Side MOSFET (Q1) Specifications | CSD19538Q3A
 |  |  | On-State Resistance, RDS(on) | 52 | mΩ
 |  |  | Total Gate Charge, QG | 3.2 | nC
 |  |  | Gate-Drain Charge, QGD | 0.8 | nC
 |  |  | Gate-Source Charge, QGS | 1.6 | nC
 |  |  | Output Capacitance, COSS | 69 | pF
 |  |  | Gate Resistance, RG | 4.6 | Ω
 |  |  | Transconductance, gFS | 45 | S
 |  |  | Gate-Source Plateau Voltage, VGS(MP) | 5 | V
 |  |  | Body Diode Forward Voltage, VBD1 | 0.8 | V
 |  |  | Thermal Resistance, θJA | 55 | °C/W
 |  |  | Low-Side MOSFET (Q2) Specifications | NVMFS6B14NL
 |  |  | On-State Resistance, RDS(on) | 10 | mΩ
 |  |  | Total Gate Charge, QG | 13 | nC
 |  |  | Output Charge, QOSS | 20 | nC
 |  |  | Output Capacitance, COSS | 580 | pF
 |  |  | Body Diode Forward Voltage, VBD2 | 0.9 | V
 |  |  | Body Diode Recovery Charge, QRR | 50 | nC
 |  |  | Thermal Resistance, θJA | 40 | °C/W
Step 9: IC Power Loss
 |  |  | IC Power Dissipation | 0.10 | W
 |  |  | IC Junction Temperature Rise (est) | 5.0 | °C

Sheet: Schematic & BOM
 | ** Tie SYNCIN to VCC and GND for CCM and DCM operation, respectively **
VIN = 30V, VOUT = 14V, IOUT = 9A, Fsw = 332kHz, Current Limit = 13A
Wide VIN, High Efficiency Synchronous Buck Regulator BOM
Count | Ref Des | Value | Description | Size | Part Number | MFR | Footprint (mm) | Area (mm2)
1 | CBOOT | 0.1µF | Capacitor, Ceramic,0.1µF, 25V, X7R, 20% |  | Std | Std | 1.6 x 0.8 | 1.3 |  |  |  | 2
1 | CC1 | 4700pF | Capacitor, Ceramic,4700pF, 16V, X7R, 10% |  | Std | Std | 1.6 x 0.8 | 1.3 |  |  |  | 2
1 | CC2 | 120pF | Capacitor, Ceramic,120pF, 50V, NP0, 5% |  | Std | Std | 1.6 x 0.8 | 1.3 |  |  |  | 2
1 | CC3 | 1000pF | Capacitor, Ceramic,1000pF, 50V, NP0, 5% |  | Std | Std | 1.0 x 0.5 | 0.5 |  |  |  | 1
1 | CS | 8,2pF | Capacitor, Ceramic, 8,2pF, 100V, X7R, 20% |  | Std | Std | 1.6 x 0.8 | 1.3 |  |  |  | 2
3 | CIN | 4.7µF | Capacitor, Ceramic, 4.7µF, 50V, X7R, 10% |  | Std | Std | 3.2 x 1.6 | 15.3 |  |  |  | 4
4 | COUT | 22µF | Capacitor, Ceramic, 22µF, 25V, X7R, 10% |  | Std | Std | 3.2 x 1.6 | 20.4 |  |  |  | 4
1 | CSS | 47nF | Capacitor, Ceramic,47nF, 16V, X7R, 10% |  | Std | Std | 1.6 x 0.8 | 1.3 |  |  |  | 2
1 | CVCC | 2.2µF | Capacitor, Ceramic,2.2µF, 25V, X7R, 20% |  | Std | Std | 2.0 x 1.25 | 2.5 |  |  |  | 3
1 | CVIN | 0.1µF | Capacitor, Ceramic,0.1µF, 50V, X7R, 20% |  | Std | Std | 1.6 x 0.8 | 1.3 |  |  |  | 2
1 | LO | 6.8µH | Inductor, 6,8µH, 0,88mΩ, >18A |  | Various | Various | 10.0 x 10.0 | 100.0 |  |  |  | 7
1 | Q1 | See description | MOSFET, N-CH, 80V/100V,52mΩ |  | CSD19538Q3A | TI | 5.0 x 6.0 | 30.0 |  |  |  | 1 | 1
1 | Q2 | See description | MOSFET, N-CH, 80V/100V,10mΩ |  | NVMFS6B14NL | TI | 5.0 x 6.0 | 30.0 |  |  |  | 1 | 1
1 | RC1 | 6.65k | Resistor, Chip,6.65kΩ, 1/16W, 1% |  | Std | Std | 1.0 x 0.5 | 0.5 |  |  |  | 1
1 | RC2 | 768 | Resistor, Chip,768Ω, 1/16W, 1% |  | Std | Std | 1.0 x 0.5 | 0.5 |  |  |  | 1
1 | RILIM | 562 | Resistor, Chip,562Ω, 1/16W, 1% |  | Std | Std | 1.0 x 0.5 | 2.5 |  |  |  | 3
1 | RRT | 30.1k | Resistor, Chip,30.1kΩ, 1/16W, 1% |  | Std | Std | 1.0 x 0.5 | 0.5 |  |  |  | 1
1 | RFB1 | 26.4k | Resistor, Chip,26.4kΩ, 1/16W, 1% |  | Std | Std | 1.0 x 0.5 | 0.5 |  |  |  | 1
1 | RFB2 | 1.58k | Resistor, Chip,1.58kΩ, 1/16W, 1% |  | Std | Std | 1.0 x 0.5 | 0.5 |  |  |  | 1
1 | RPGOOD | 20k | Resistor, Chip,20kΩ, 1/16W, 1% |  | Std | Std | 1.0 x 0.5 | 0.5 |  |  |  | 1
1 | RS | 6mΩ | Resistor,6mΩ, 1/4W, 1% | 1206 | Std | Std | 3.2 x 1.6 | 0.0
1 | RUV1 | 200k | Resistor, Chip,200kΩ, 1/16W, 1% |  | Std | Std | 1.6 x 0.8 | 1.3 |  |  |  | 2
1 | RUV2 | 8.25k | Resistor, Chip,8.25kΩ, 1/16W, 1% |  | Std | Std | 1.0 x 0.5 | 0.5 |  |  |  | 1
1 | RVIN | 2.2 | Resistor, Chip,2.2Ω, 1/16W, 1% |  | Std | Std | 1.0 x 0.5 | 0.5 |  |  |  | 1
1 | U1 | LM5146-Q1 | IC, LM5146-Q1, PWM Controller, 5.5V-100V Input | VQFN-20 | LM5146QRGYRQ1 | TI | 3.5 x 4.5 x 1.0 | 15.75
 |  |  |  |  | Total Solution Size (buffered by 25%) |  |  | 287.6 | mm2 = | 0.4457 | in2
NOTES:
** Inductor saturation current should be higher than the current limit setpoint at all operating temperatures **
** Effective output capacitance should be appropriately derated for applied voltage and temperature, particularly with ceramics **
 |  |  |  |  |  |  |  |  |  |  |  | 2

Sheet: EVMs
LM(2)5145/6/-Q1 Quickstart Calculator
 | LM5146-Q1-EVM12V
 | LM5145EVM-HD-20A PCB Layout
 |  | Top
 |  | Layer | x
 |  | Layer 2
 |  | Layer 3
 |  | Bottom
