gokberkgucin/MIT_Buck_Converter_Design_TAMAMLANDI/FINAL_QA.md

# Final QA

Bu dosya, README landing page, `docs/` giriş sayfası ve tam rapor için son kalite kontrol kaydıdır. Kontrol, kaynak DOCX’in teknik omurgasının repo çıktısında korunup korunmadığını ve GitHub üzerinde okunabilir bir navigasyon kurulup kurulmadığını değerlendirir.

## Kontrol Kapsamı

| Alan | Dosya / klasör |
|---|---|
| Landing page | [README.md](README.md) |
| Docs giriş sayfası | [docs/index.md](docs/index.md) |
| Tam teknik rapor | [docs/full-report.md](docs/full-report.md) |
| Verification özeti | [docs/verification-summary.md](docs/verification-summary.md) |
| Source map | [docs/source-map.md](docs/source-map.md) |
| Transfer audit | [docs/TRANSFER_AUDIT.md](docs/TRANSFER_AUDIT.md) |
| QA betiği | [tools/check_docs_quality.py](tools/check_docs_quality.py) |

## Otomatik Kontrol Özeti

`tools/check_docs_quality.py` ile README, FINAL_QA, docs index, full report, verification summary, source map ve transfer audit üzerinde link, image, anchor, encoding ve içerik tutarlılığı kontrolleri yapıldı. Son koşuda 7 dosya kontrol edildi.

| Kontrol | Sonuç | Not |
|---|---|---|
| Kırık link | Geçti | `broken_links=0`. |
| Eksik görsel | Geçti | `missing_images=0`; `docs/full-report.md` içinde 54 görsel referansı var. |
| Kullanılmayan DOCX media | Geçti | `docx_media_total=53`, `docx_media_unique_linked=53`, `docx_media_unlinked=0`. |
| Bozuk Türkçe karakter | Geçti | `mojibake_files=0`. |
| Absolute path | Geçti | `absolute_path_files=0`. |
| Başlık sırası | Geçti | `missing_key_anchors=0`; ana DOCX bölümleri stabil HTML anchor’larla korunuyor. |
| Full-report eksik bölüm | Geçti | Kapak, Abstract, Bölüm 1-8, Kaynaklar ve Ekler mevcut. |
| Verification / full-report çelişkisi | Geçti | `verification_value_mismatches=0`; kritik değerler iki dosyada da aynı: `49.5957`, `124.1839`, `1.30`, `8.58`, `37.38`, `97.78`. |
| Korunan mevcut dosyalar | Geçti | Kaynak DOCX/PDF, LTspice klasörü, görsel klasörleri ve ana referanslar README/docs index üzerinden bağlandı. |
| Summary-only kalan yer | Geçti | `summary_only_hits=0`; README özet/navigasyon, teknik içerik uzun formda `docs/full-report.md` içinde. |
| Açık yapılacak-notu kalan yer | Geçti | `todo_hits=0`. |

## Kaynak DOCX ile Repo Çıktısı Karşılaştırması

| Kaynak omurga | Repo çıktısı | Değerlendirme |
|---|---|---|
| 32 kaynak başlık | `docs/full-report.md` içinde 51 Markdown başlığı ve stabil anchor’lar | Ana bölüm omurgası korunmuş, bazı alt başlıklar okunabilirlik için genişletilmiş. |
| Kapak / Abstract / İçindekiler | [full-report.md#kapak](docs/full-report.md#kapak), [#abstract](docs/full-report.md#abstract), [#icindekiler](docs/full-report.md#icindekiler) | Aktarıldı ve GitHub TOC tıklanabilir hale getirildi. |
| Bölüm 1-4 | [Giriş](docs/full-report.md#giris) ile [durum denklemleri](docs/full-report.md#cevirici-durum-denklemleri) arası | Frekans mantığı, $C R_{ESR}$, $CL$ aralığı, L/C/ESR seçimi ve ESR etkisi korunmuş. |
| Bölüm 5-6 | [Kontrolcü tasarımı](docs/full-report.md#kontrolcu-tasarimi) ve [op-amp gerçekleme](docs/full-report.md#op-amp-devresi-gerceklemesi) | Sensor gain, $G_{vd}(s)$, loop gain, lead/lag/PID, op-amp kutbu ve eleman değerleri korunmuş. |
| Bölüm 7 | [Benzetim sonuçları](docs/full-report.md#benzetim-sonuclari) | Gereksinim ve sonuçlar aynı akışta karşılaştırılabilir hale getirildi. |
| Bölüm 8 / Kaynaklar / Ekler | [Projenin geleceği](docs/full-report.md#projenin-gelecegi), [Kaynaklar](docs/full-report.md#kaynaklar), [Ekler](docs/full-report.md#ekler) | LM5146, referanslar, sığaç veri sayfası ve genel devre görünümü eklendi. |
| 53 çıkarılmış DOCX medya nesnesi | 54 rapor içi görsel referansı, 53 benzersiz medya hedefi | Tüm DOCX medya dosyaları rapora bağlandı; 5 çok küçük medya nesnesi ölçeklenerek gösterildi. |
| 28 kaynak tablo | Ana hesap ve doğrulama tabloları Markdown’a yeniden kuruldu | Otomatik tablo sayısı birebir aynı değildir; teknik karşılıklar elle güçlendirildi. |
| 151 OOXML math object | Kritik denklemler Markdown math veya açıklamalı figür bağlamıyla aktarıldı | Denklemler tamamen sessizce düşürülmedi; karmaşık/figür tabanlı yerler source map ile izleniyor. |

## README / Docs Entry Kontrolü

| Gereksinim | Durum |
|---|---|
| Güçlü kısa proje tanımı | Tamamlandı |
| Temel tasarım spesifikasyonları | Tamamlandı |
| Verification özeti | Tamamlandı |
| Önemli görseller | Tamamlandı |
| Depo içi navigasyon | Tamamlandı |
| Full report bağlantısı | Tamamlandı |
| LTspice/simülasyon bağlantıları | Tamamlandı |
| Ana kaynak dosyalar bağlantıları | Tamamlandı |
| Relative link kullanımı | Tamamlandı |
| GitHub uyumluluğu / `.nojekyll` | Tamamlandı |

## Korunan Dosyalar ve Bağlantı Durumu

| Korunan içerik | Bağlantı | Durum |
|---|---|---|
| Ana DOCX | [Birinci_donem_Buck_Converter_Serbest_Projesi.docx](Birinci_donem_Buck_Converter_Serbest_Projesi.docx) | Bağlandı |
| Ana PDF | [Birinci_donem_Buck_Converter_Serbest_Projesi.pdf](Birinci_donem_Buck_Converter_Serbest_Projesi.pdf) | Bağlandı |
| Docs originals | [docs/originals/](docs/originals/) | Bağlandı |
| DOCX medya seti | [docs/assets/docx-media/media/](docs/assets/docx-media/media/) | Bağlandı |
| LTspice kaynakları | [LTspice_AveragedSwitchModelingSimulation/](LTspice_AveragedSwitchModelingSimulation/) | Bağlandı |
| Eski README görselleri | [images/readme/](images/readme/) | Bağlandı |
| Eski DOCX çıkarımı | [images/docx_extracted/](images/docx_extracted/) | Bağlandı |
| Orijinal simülasyon ekran görüntüleri | [ekran gorüntüleri/](ekran%20gor%C3%BCnt%C3%BCleri/) | Bağlandı |
| MIT proje şartnamesi | [G5_mit6_622_s23_designproj.pdf](G5_mit6_622_s23_designproj.pdf) | Bağlandı |
| LM5146-Q1 datasheet | [G32_lm5146-q1.pdf](G32_lm5146-q1.pdf) | Bağlandı |

## Manuel Takip Gerekenler

| Öğe | Durum |
|---|---|
| `image12.png`, `image13.png`, `image30.png`, `image32.png`, `image33.png` | `docs/full-report.md` içine bağlandı ve çok küçük oldukları için ölçeklenerek gösterildi; PDF render ile teknik içerik taşıyıp taşımadıkları son kez teyit edilebilir. |
| `LTspice_AveragedSwitchModelingSimulation/SyncBuck_switching_CL.raw` | Yaklaşık 523 MB olduğu için GitHub commit’ine alınmadı; harici bulut veya release asset olarak paylaşılmalı. |
| Input voltage transient | Gereksinim korunuyor; kaynak raporda ayrı görsel doğrulama yok. |
| Input current ripple | Gereksinim korunuyor; kaynak raporda ayrı görsel doğrulama yok. |
| Sıcaklık sweep | Gereksinim korunuyor; kaynak raporda ayrı sıcaklık analizi yok. |
| Üçüncü taraf PDF/TXT dosyaları | Reference/source material olarak bağlandı; lisans/dağıtım uygunluğu ayrıca kontrol edilmeli. |

## Sonuç

Repo artık kısa README özetinden çıkıp GitHub’da gezilebilir bir teknik proje reposu haline getirildi. Tam içerik `docs/full-report.md` içinde, hızlı doğrulama `docs/verification-summary.md` içinde, kaynak eşleme `docs/source-map.md` içinde ve son kalite kontrol bu dosyada tutuluyor.
