gokberkgucin/MIT_Buck_Converter_Design_TAMAMLANDI/docs/final-validation-report.md

# Final Validation Report

Bu rapor, kaynak DOCX tezi ile GitHub hedef çıktısı arasındaki son kalite kontrol kaydıdır.

## Genel Sonuç

Final denetim başarılıdır. `README.md` repo giriş kapısı olarak ilk görünür blokta `docs/full-report.md` dosyasına yönlendiriyor; `docs/full-report.md` kaynak tezin ana teknik okuma yüzeyi olarak kullanılabilir durumda.

Son otomatik QA sonucu:

| Kontrol | Sonuç |
|---|---:|
| Kırık link | 0 |
| Eksik görsel | 0 |
| Mojibake dosyası | 0 |
| Absolute path | 0 |
| Kullanılmayan DOCX media | 0 |
| Full-report görsel referansı | 54 |
| Benzersiz bağlı DOCX medya | 53 / 53 |

## Coverage Özeti

| Alan | Kaynak DOCX | Hedef durum |
|---|---:|---:|
| Ana başlık omurgası | 31 başlık | Tamamı `docs/full-report.md` içinde temsil ediliyor |
| Boş olmayan kaynak blokları | 258 blok | Ana teknik bloklar Markdown metni, tablo, denklem veya görsel bağlamıyla temsil ediliyor |
| Word tablo sayısı | 28 | Semantik Markdown tablolarına dönüştürüldü |
| Native Word denklem nesnesi | 151 `oMath` | Kritik denklemler Markdown math olarak yazıldı; karmaşık ifade görselleri manifestte tutuldu |
| Native Word denklem paragrafı | 65 `oMathPara` | 118 display math bloğu + 14 equation-image asset ile temsil ediliyor |
| DOCX medya dosyası | 53 | 53 asset manifestte, 53 benzersiz asset full report içinde kullanılıyor |
| Full-report görsel referansı | - | 54 referans; `image38` iki bağlamda kullanıldığı için referans sayısı medya sayısından fazla |

Denetlenen ana omurga:

- `ABSTRACT`
- `İÇİNDEKİLER`
- `GİRİŞ`
- `Çalışmanın Amacı ve Kapsamı`
- `Buck Converter Nedir?`
- `Güç ve Kontrol Tasarımında İzlenen Yöntem`
- `Frekans Seçim Kuralları ve Hesaplamalar`
- `Hesaplamalarda Kullanılacak Parametreler`
- `Güç Katı Hesaplamaları`
- `Çevirici Durum Denklemleri`
- `ESR Etkisi`
- `Genel Dalga-Biçimleri`
- `Kontrolcü Tasarımı`
- `Kontrolcü Hesabı`
- `Op-amp devresi -gerçeklemesi`
- `Sensor Gain (H(s))`
- `Compensator Devresi`
- `Benzetim sonuçları`
- `Tasarım Gereksinimleri`
- `Benzetimde kullanılan elemanlar ve parametreler`
- `Çıkış Gücü`
- `Output Voltage (static requirement)`
- `Output Voltage (transient limits)`
- `Allowed output voltage ripple (p-p, any R load)`
- `Verimlilik`
- `Hesaplamaların Doğrulanması`
- `PROJENIN GELECEĞİ`
- `KAYNAKLAR`
- `EKLER`
- `EK-1. Sığaç Verisayfası`
- `EK-2. Genel görünüm`

## Eksik Kalan İçerik

Migration açısından eksik kalan ana başlık, anlamlı görsel veya açıkça temsil edilmeyen teknik bölüm saptanmadı.

Kaynak raporda hedef olarak yer alan ama ayrı dalga şekliyle kanıtlanmayan konular şunlardır:

- Input voltage transient dayanımı
- Input current ripple
- Sıcaklık sweep / sıcaklık aralığı

Bunlar Markdown aktarım eksikliği değil, kaynak raporun doğrulama kapsamındaki açık takip maddeleridir.

## Düzeltilen Son Hatalar

Bu final turunda bulunan ve düzeltilen küçük sorun:

- `docs/full-report.md` içindeki `İçindekiler` başlığı kaynak tez omurgasına daha yakın olması için `İÇİNDEKİLER` olarak güncellendi.

Önceki QA turundan gelen ve bu denetimde tekrar doğrulanan düzeltmeler:

- `README.md` ilk görünür blokta doğrudan tam rapora yönlendiriyor.
- Full-report görselleri semantik `docs/assets/full-report/...` asset yollarını kullanıyor.
- Kaynak DOCX placeholder/onay artefaktları yayın raporuna taşınmıyor.
- Bookmark/Word alan hatası hedef Markdown içine taşınmadı.
- Mojibake, kırık link, eksik görsel ve absolute path kalmadı.

## Kalan Riskler

- Native Word denklemleri birebir OMML nesnesi olarak Markdown'a taşınmadı; kritik denklemler Markdown math veya equation-image olarak korunuyor. Tam görsel sadakat için kaynak PDF ile yan yana render kontrolü en güvenilir son adımdır.
- Kaynak Word tablolarının bir kısmı layout/denklem taşıyıcısı gibi kullanılmıştır; hedefte semantik Markdown tablo tercih edildi.
- `LTspice_AveragedSwitchModelingSimulation/SyncBuck_switching_CL.raw` yaklaşık 523 MB olduğu için commit dışında bırakılmaya devam ediyor.
- Üçüncü taraf PDF/TXT referans materyalleri için lisans/dağıtım uygunluğu ayrıca değerlendirilmeli.

## Değişen Dosyalar

Bu dokümantasyon dönüşüm ve final QA sürecinde öne çıkan değişiklikler:

- `README.md`
- `docs/full-report.md`
- `docs/assets/full-report/`
- `docs/assets/full-report/manifest.md`
- `docs/assets/full-report/manifest.json`
- `docs/migration-gap-report.md`
- `docs/migration-coverage.csv`
- `docs/formatting-fixes.md`
- `docs/final-validation-report.md`
- `tools/extract_thesis_assets.py`
- `tools/check_docs_quality.py`

## Önerilen Commit Mesajı

```text
docs: finalize thesis report migration and validation
```
