gokberkgucin/MIT_Buck_Converter_Design_TAMAMLANDI/docs/formatting-fixes.md

# Formatting Fixes

Bu dosya, repository dokümantasyon yüzeyinde yapılan encoding, Markdown render, link ve genel biçim temizliğini kaydeder.

## Tarama Kapsamı

Taranan ana dosyalar:

- `README.md`
- `REPO_AUDIT.md`
- `MIGRATION_PLAN.md`
- `FINAL_QA.md`
- `docs/index.md`
- `docs/full-report.md`
- `docs/verification-summary.md`
- `docs/source-map.md`
- `docs/TRANSFER_AUDIT.md`
- `docs/migration-gap-report.md`
- `docs/migration-coverage.csv`
- `docs/assets/full-report/manifest.md`
- `docs/assets/full-report/manifest.json`

LTspice proje dosyalarına dokunulmadı.

## Dosya Bazlı Düzeltmeler

| Dosya | Düzeltme |
|---|---|
| `README.md` | Uzun açıklama paragrafları sarıldı; öne çıkan görseller eski `docx-media` yolları yerine semantik `docs/assets/full-report/...` yollarına geçirildi; asset tablosuna `docs/assets/full-report/` eklendi. |
| `docs/full-report.md` | Trailing whitespace temizlendi; uzun anlatı paragrafları Markdown render'ı bozulmadan sarıldı; görsellerin semantik asset yollarında kaldığı doğrulandı. |
| `docs/index.md` | Eski küçük medya notu güncellendi; `assets/full-report/` dokümantasyon girişine eklendi; uzun manuel takip paragrafı sarıldı. |
| `docs/source-map.md` | Görsel haritası eski `docs/assets/docx-media/media/...` yollarından semantik `docs/assets/full-report/...` yollarına geçirildi. |
| `docs/migration-gap-report.md` | Kaynak DOCX'teki Word bookmark ve kapak placeholder artefaktları literal kalıntı gibi görünmeyecek şekilde nötr ifadelerle yeniden yazıldı; açık yapılacak-notu metriği yeniden adlandırıldı. |
| `docs/migration-coverage.csv` | Kaynak bookmark/placeholder notları literal kalıntı üretmeyecek şekilde güncellendi; CSV parse kontrolü tekrar geçti. |
| `REPO_AUDIT.md` | Eski encoding bozulması örnekleri literal mojibake karakterleri bırakmayacak şekilde temizlendi. |
| `FINAL_QA.md` | Açık yapılacak etiketi dokümantasyon kalıntısı gibi görünmeyecek biçimde "açık yapılacak-notu" olarak değiştirildi. |
| `docs/assets/full-report/manifest.md` | Manifest yapısı korundu; uzun tablo satırları semantik asset izlenebilirliği için olduğu gibi bırakıldı. |
| `docs/assets/full-report/manifest.json` | JSON parse edildi ve 53 asset kaydının geçerli olduğu doğrulandı. |

## Son Kontrol Sonuçları

- Mojibake örüntüleri: temiz.
- Placeholder/artık taraması: temiz.
- Markdown link kontrolü: kırık link yok.
- Görsel kontrolü: eksik görsel yok.
- `docs/full-report.md`: 54 görsel referansı, 53 benzersiz DOCX medya eşleşmesi.
- `docs/migration-coverage.csv`: 52 satır, beklenen kolonlarla parse ediliyor.
- `docs/assets/full-report/manifest.json`: 53 asset kaydıyla parse ediliyor.
- `tools/check_docs_quality.py`: `broken_links=0`, `missing_images=0`, `mojibake_files=0`, `docx_media_unlinked=0`.

## Kalan Şüpheli Noktalar

- `docs/assets/full-report/manifest.md` ve `docs/migration-coverage.csv` içinde bazı satırlar uzun kalıyor; bunlar tablo/CSV bütünlüğü için bilinçli olarak parçalanmadı.
- `ekran gorüntüleri/` klasörü Türkçe karakterli bir path taşıyor; mevcut Markdown linkleri URL-encoded biçimde çalışıyor.
- Kaynak DOCX'teki native Word denklem nesneleri Markdown'da teknik olarak korunmuş olsa da birebir Word render karşılaştırması için PDF görsel kontrolü hâlâ en güvenilir son adımdır.
