gokberkgucin/MIT_Buck_Converter_Design_TAMAMLANDI/LTspice_AveragedSwitchModelingSimulation/Boost_regulator_practice_problem.asc

C1: cap; 33µF
Cc: cap; ?
D1: diode; RF1501TF3S
L1: ind; 100µH
M1: nmos; IPB600N25N3
Rg2: res; 5
RL: res; 0.2
Rload: res; 12
Rs1: res; ?
Rs2: res; 10K
U1: PWM; VM=4V, fs=200kHz
U3: LT1630
U4: Driver
Vdd: voltage; 5V
Vg: voltage; 48V
VGG: voltage; 12V
Vref: voltage; 2.5V
Named nets: 0, g1, in, sw, out, c, vc, ref, VDD
.lib switching.lib
.tran 0 10ms 0ms 0.2u uic
Boost regulator
Power Electronics
University of Colorado Boulder
.meas Vout avg v(out) from 9.9ms
.meas Pout avg v(out)*i(Rload) from 9.9ms
.meas Pin avg v(in)*i(L1) from 9.9ms
.meas Efficiency param Pout/Pin
Values of Rs1 and Cc to be found in
Practice Problem: Spice Simulation
