gokberkgucin/MIT_Buck_Converter_Design_TAMAMLANDI/LTspice_AveragedSwitchModelingSimulation/test_CCM5.asc

C1: cap; 10µF
Ig: current; 10A
Rload: res; 10
U1: ccm5; Ron=0.1 VD=1V
Vd: voltage; 0.5
Named nets: 0, out, in, d
.lib average.lib
.tran 0 1ms 0 1us uic
Simple CCM5 test circuit: 
a current-driven boost
 
Power Electronics 
University of Colorado Boulder
What is the efficiency?
