gokberkgucin/MIT_Buck_Converter_Design_TAMAMLANDI/LTspice_AveragedSwitchModelingSimulation/boost_average.asc

C1: cap; 33µF
L1: ind; 100µH
RL: res; {RL}
Rload: res; 20ohm
U1: ccm1
Vduty: voltage; PWL(0 0.4 5.01m 0.4 5.02m 0.6); AC 1
Vg: voltage; 24
Named nets: 0, out, sw, d, in
Simulation directives
.lib average.lib
Boost converter averaged model
 
Power Electronics
University of Colorado Boulder
Boost converter
averaged model
.tran 0 5.3m 5m 1u
;ac dec 300 10 100k
;dc Vduty 0.2 0.9 0.01
;.step param RL 0.1 0.5 0.2
.param RL = 0.1
