gokberkgucin/MIT_Buck_Converter_Design_TAMAMLANDI/LTspice_AveragedSwitchModelingSimulation/boost_switching.asc

C1: cap; 33µF
D1: diode; RF1601NS2D
L1: ind; 100µH
M1: nmos; IRFS4010
Rg: res; 10
RL: res; {RL}
Rload: res; 20ohm
U1: Driver
U2: PWM
Vdd_driver: voltage; 12
Vduty: voltage; PWL(0 0.4 5.01m 0.4 5.02m 0.6)
Vg: voltage; 24
Named nets: 0, out, sw, Vgate, vc, c, vdd, g, in
.tran 0 5.3m 5m 20e-9
Gate driver
Pulse-width modulator
Simulation directives
.lib switching.lib
.options reltol=0.0005
Boost converter switching at 100kHz
 
Power Electronics 
University of Colorado Boulder
Boost converter
switching model
.param RL = 0.1
