gokberkgucin/MIT_Buck_Converter_Design_TAMAMLANDI/LTspice_AveragedSwitchModelingSimulation/BuckRegulator9-5-4_avg.asc

B1: bv; V=limit(0.25*v(x),0.1,0.9)
C1: cap; 3.5nF
C2: cap; 3.2nF
Cf: cap; 500µF
L1: ind; 50µH
R1: res; 27k
R1d: res; 10k
R2: res; 100k
R2d: res; 5k
Rload: res; {RL}
U1: LT1211
U2: ccm-dcm1; L=50uH fs=100k
Vdd: voltage; 12
Vg: voltage; 28
Vref: voltage; 5
vz: voltage; ""; AC 1
Named nets: 0, Vout, Vsw, Vref, vdd, x, y
;tran 0 5m 0 10u uic
.lib average.lib
.ac dec 300 5 50k
Buck voltage regulator
 
Power Electronics
University of Colorado Boulder
.step param RL list 3 25
.meas crossover find v(y)/v(x) when mag(v(y)/v(x))=1
