gokberkgucin/MIT_Buck_Converter_Design_TAMAMLANDI/LTspice_AveragedSwitchModelingSimulation/DCMBuck_regulator_average_CL.asc

Bpwm: bv; V=limit(v(ctrl), 0, 0.9)
C1: cap; 9.2pF
C2: cap; 160pF
Cout: cap; 22µF ic=0
L1: ind; 0.25µH ic=0
R1: res; 10K
R2: res; 69K
R3: res; 25
RL: res; 20mOhm
U1: ccm-dcm1; L=0.25uH fs=1MEG
U3: LT1499
Vg: voltage; 3.3V
Vref1: voltage; 0.5; AC 0
Vref: voltage; PWL(0 0 50u 2.5 200u 2.5); AC 0
Vz: voltage; ""; AC 1
Named nets: 0, out, sw, in, ctrl, y
.lib average.lib
.tran 0 200us 0 10n uic
2.5V, 1A point-of-load (POL) 
voltage regulator operating at 1MHz
 
Power Electronics
University of Colorado Boulder
;ac dec 200 10 1meg
;.nodeset v(ctrl)=0.5 v(sw)=0 v(out)=0
