gokberkgucin/MIT_Buck_Converter_Design_TAMAMLANDI/LTspice_AveragedSwitchModelingSimulation/Flyback_average.asc

Cout: cap; 100µF
Rload: res; 10
U1: ccm-dcm2; L={LM} fs={fs}
U2: transformer; n={n} LM={LM}
Vduty: voltage; 0.2
Vg: voltage; 380V
Named nets: 0, in, out
.lib average.lib
.tran 0 5ms 0 uic
Flyback converter averaged model
 
Power Electronics
University of Colorado Boulder
.param LM=1mH n=0.1 fs=200kHz
.step param LM list 1mH 5mH
