gokberkgucin/MIT_Buck_Converter_Design_TAMAMLANDI/LTspice_AveragedSwitchModelingSimulation/Flyback_average_dcm.asc

Cout: cap; 680µF
Itest: current; ""; AC 0
Rload: res; {R}
U1: ccm-dcm2; L={LM} fs={fs}
U2: transformer; n={n} LM={LM}
Vduty: voltage; 0.51; AC 1
Vg: voltage; 48V; AC 0
Named nets: 0, in, out
.lib average.lib
Flyback converter averaged model
DCM versus CCM operation
 
Power Electronics
University of Colorado Boulder
.param LM=200uH n=0.1 fs=150kHz
.step param R list 1 2 3
.ac dec 300 10 100k
