gokberkgucin/MIT_Buck_Converter_Design_TAMAMLANDI/LTspice_AveragedSwitchModelingSimulation/load.asc

iload: current; {Iload}; AC 1
S1: sw; loadSW
Vswload: voltage; PULSE(1 0 50u 1u 1u 100u 200u)
Named nets: 0, out
.model loadSW SW(Ron={Ron} Roff={Roff} Vt = 0.5)
Example load switch for testing step-load transients
and output impedance (for averaged models)
 
Power Electronics 
University of Colorado Boulder
.param Ron = 1 Roff = 10 Iload = -1
.tran 0 200u 0 1u
