gokberkgucin/MIT_Buck_Converter_Design_TAMAMLANDI/LTspice_AveragedSwitchModelingSimulation/PID_compensator.asc

C2: cap; 1.3nF
C4: cap; 1.5nF
R1: res; 3.0K
R2: res; 16K
R4: res; 360
U5: LT1215
Vg: voltage; 5V
Vout: voltage; 1.79873V; AC 1
Vref: voltage; 1.8
Named nets: 0, in, ctrl
PID compensator example
 
Power Electronics
University of Colorado Boulder
;dc Vout 1.79 1.8 0.1u
;op
.ac dec 500 10 10MEG
The compenstaor has very large gain at dc;
DC operating point must be set using 
high-resolution dc sweep
