gokberkgucin/MIT_Buck_Converter_Design_TAMAMLANDI/LTspice_AveragedSwitchModelingSimulation/SEPIC_average_loss.asc

C1: cap; 100µF
C2: cap; 100µF
L1: ind; 800µH
L2: ind; 100µH
RL1: res; 0.5
RL2: res; 0.1
Rload: res; 50
U2: ccm2; Ron={Ron}
Vduty: voltage; 0.5
Vg: voltage; 50V
Named nets: 0, out, 1, 2, 3, d
.lib average.lib
.dc Vduty 0.1 1 0.01
.step param Ron 0 1 0.5
SEPIC average model
 
Power Electronics 
University of Colorado Boulder
