gokberkgucin/MIT_Buck_Converter_Design_TAMAMLANDI/LTspice_AveragedSwitchModelingSimulation/SyncBuck_average_CL.asc

B1: bv; V=limit(v(ctrl), 0.05, 0.9)
C1: cap; 200µF ic=0V
C2: cap; 1.3nF
C4: cap; 1.5nF
Iload: current; PULSE(0 5 150u 1u 1u 25u 200u)
L1: ind; 1µH ic=0A
R1: res; 3.0K
R2: res; 16K
R4: res; 360
Resr: res; 0.8mOhm
RL: res; 15mOhm
Rload: res; 1k
Ron: res; 15mOhm
U1: ccm1
U5: LT1215
Vg: voltage; 5V
Vref: voltage; PWL(0 0 50u 1.8V)
Named nets: 0, out, sw, in, ctrl
.lib average.lib
.tran 0 200us 0 10n uic
1.8V, 5A point-of-load (POL) 
voltage regulator operating at 1MHz
 
Power Electronics
University of Colorado Boulder
