gokberkgucin/MIT_Buck_Converter_Design_TAMAMLANDI/LTspice_AveragedSwitchModelingSimulation/SyncBuck_average_fresponses.asc

B1: bv; V=limit(v(ctrl), 0.05, 0.9)
C1: cap; 200µF
C2: cap; 1.3nF
C4: cap; 1.5nF
Iload: current; 5A; AC 0
L1: ind; 1µH
R1: res; 3.0K
R2: res; 16K
R4: res; 360
Resr: res; 0.8mOhm
RL: res; 15mOhm
Rload: res; 1k
Ron: res; 15mOhm
U1: ccm1
U5: LT1215
Vg: voltage; 8V; AC 0
Vref: voltage; 1.8V; AC 0
Vz: voltage; ""; AC 1
Named nets: 0, out, sw, in, ctrl, d, x, y
.lib average.lib
.ac dec 300 50 500kHz
1.8V, 5A point-of-load (POL) 
voltage regulator operating at 1MHz
 
Power Electronics 
University of Colorado Boulder
.meas crossover find v(y)/v(x) when mag(v(y)/v(x))=1
