gokberkgucin/MIT_Buck_Converter_Design_TAMAMLANDI/LTspice_AveragedSwitchModelingSimulation/SyncBuck_switching_CL.asc

C1: cap; 82µF ic=0V
C2: cap; 1.59nF
C4: cap; 2.2nF
Cb: cap; 10µF
D1: schottky; 1N5817
Iload: current; 1
L1: ind; 49.42µH ic=0A
M1: nmos; BSC150N03LD
M2: nmos; BSC150N03LD
R1: res; 21K
R2: res; 100K
R3: res; 12.8k
R4: res; 2.49k
R5: res; 87.2k
Resr: res; 19.39mOhm
Rg1: res; 5
Rg2: res; 5
RL: res; 15mOhm
Rload: res; 1.569
U1: PWM; VM=4V, fs=100k
U2: dead_time; Td=30ns
U3: Driver
U4: Driver
U5: LT1215
Vg: voltage; 36
Vref: voltage; PWL(0 0 1u 1.8V)
Named nets: 0, out, g1, g2, c1, c2, sw, in, bootstrap, c, ctrl
.lib switching.lib
.options reltol=0.0005
tran 0 3000us 2ms 3n uic
Gökberk Güçin
Ron = 15 mOhm
Ron = 15 mOhm
PULSE(3.57 8.92 0.8m 1µ 1µ 0.5m 1m)
.tran 0 2000us 0 1n uic
